habworks/Hab_hc15C/SOFTWARE/HC15C/HC15C/HC15C/ReadMe.txt

========================================================================
    APPLICATION : HC15C Project Overview
========================================================================

AppWizard has created this HC15C Application for you.  

This file contains a summary of what you will find in each of the files that
make up your HC15C application.

HC15C.vcxproj
    This is the main project file for VC++ projects generated using an Application Wizard. 
    It contains information about the version of Visual C++ that generated the file, and 
    information about the platforms, configurations, and project features selected with the
    Application Wizard.

HC15C.vcxproj.filters
    This is the filters file for VC++ projects generated using an Application Wizard. 
    It contains information about the association between the files in your project 
    and the filters. This association is used in the IDE to show grouping of files with
    similar extensions under a specific node (for e.g. ".cpp" files are associated with the
    "Source Files" filter).

HC15C.cpp
    This is the main application source file.
    Contains the code to display the form.

Form1.h
    Contains the implementation of your form class and InitializeComponent() function.

AssemblyInfo.cpp
    Contains custom attributes for modifying assembly metadata.

/////////////////////////////////////////////////////////////////////////////
Other standard files:

StdAfx.h, StdAfx.cpp
    These files are used to build a precompiled header (PCH) file
    named HC15C.pch and a precompiled types file named StdAfx.obj.

/////////////////////////////////////////////////////////////////////////////
