habworks/Hab_hc15C/FIRMWARE/When the STMPE24M31.docx

When the STMPE24M31_init runs it immediately generates an IRQ. The values of the IRQ in that sequence are typically:

0x24

0x08

0x24

0x00

0x24

0x00

By sequence I mean all of these IRQs are set one after the other, even though with each read of the INT STA, I clear the INT STA.

Note I get the INT STA readings with a reading of 0x00 on the INT STA register. Not sure what that is about

Once all of the above IRQs have been cleared the touch controller should now be looking at the keys, When I touch a key I very frequently get bit 4 (abnormal bit) set. Also interesting to note, that even though the abnormal bit is set it still sees the touch event. Any time I see an abnormal event I issue what I think is an auto tune command – though I am not sure this is what an auto tune command is.

The code that actually captures the IRQ event is ISR_STMPE24M31_AandB function. It should be pretty easy to read. Note, I am confident my I2C routines are working as they should – they never return an error. Additionally I use almost identical routines on a memory device without issue. Also I have ran the I2C interface to your part at 100kHz and 200kHz – it behaves the same.

I did toy with increasing the EVR values, but to be honest I was guessing at what I was doing. Also note my desing has 2 STMPE24M31 – the second is not working – I believe this to be a hardware issue (probably a loose connection) – either way it is not responding to I2C messages. I will try and get the second device on line tomorrow – this way I can compare the operation of both units to provide you with feedback.

I have attached my C and h file as it may help you, help me.
