habworks/Hab_hc15C/DOCUMENTS/DL/IMG_8110.JPG

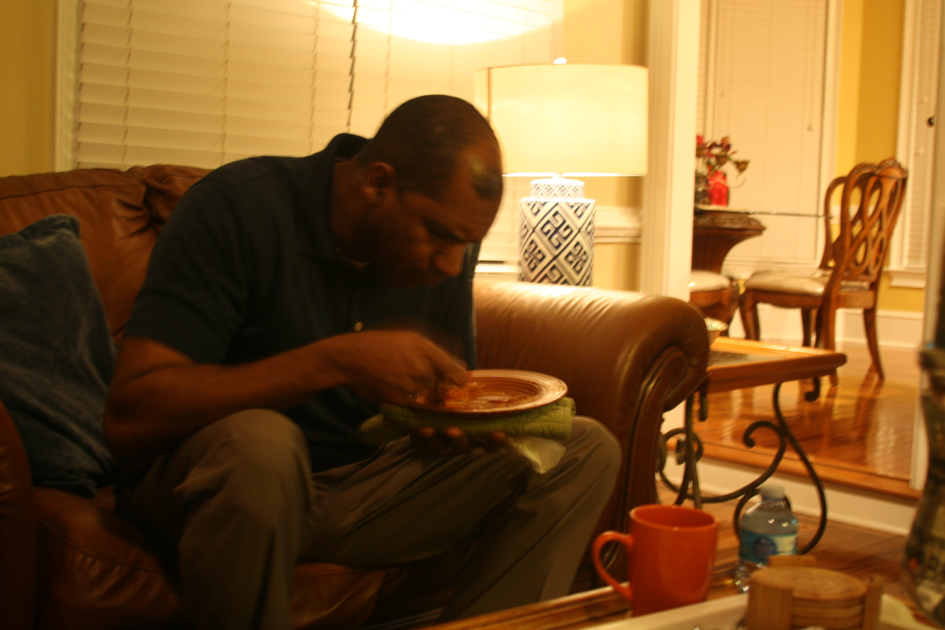
DOCUMENTS/DL/IMG_8110.JPG
