habworks/Hab_hc15C/DOCUMENTS/DL/IMG_8128.JPG

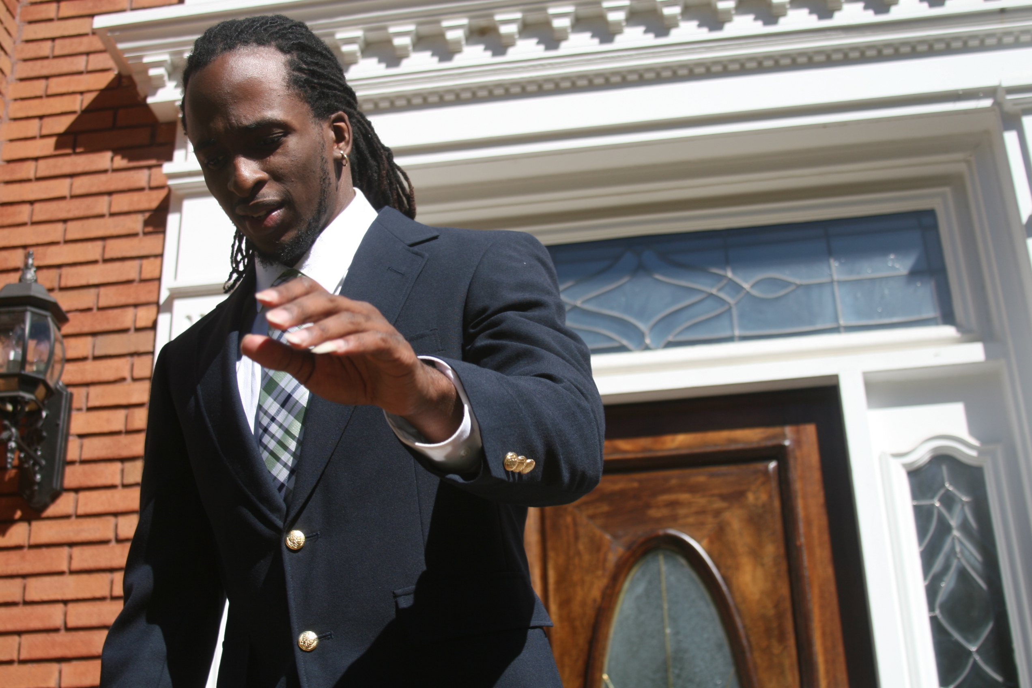
DOCUMENTS/DL/IMG_8128.JPG
