habworks/Hab_hc15C/DOCUMENTS/DL/IMG_8130.JPG

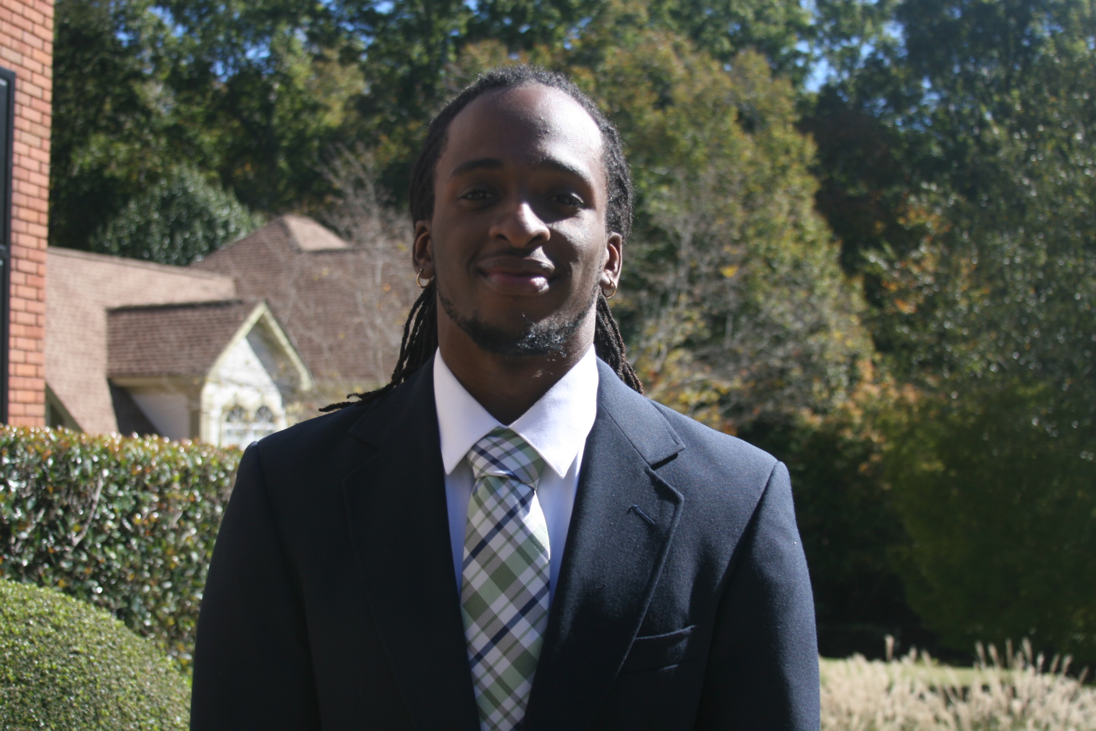
DOCUMENTS/DL/IMG_8130.JPG
