habworks/Hab_hc15C/DOCUMENTS/DL/IMG_8131.JPG

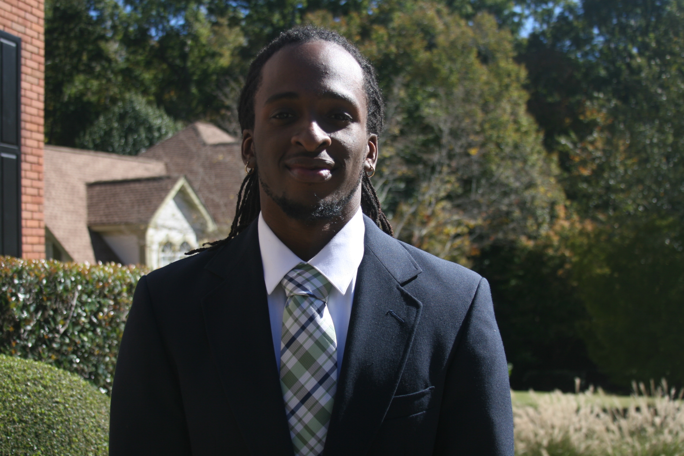
DOCUMENTS/DL/IMG_8131.JPG
