habworks/Hab_hc15C/DOCUMENTS/DL/IMG_8132.JPG

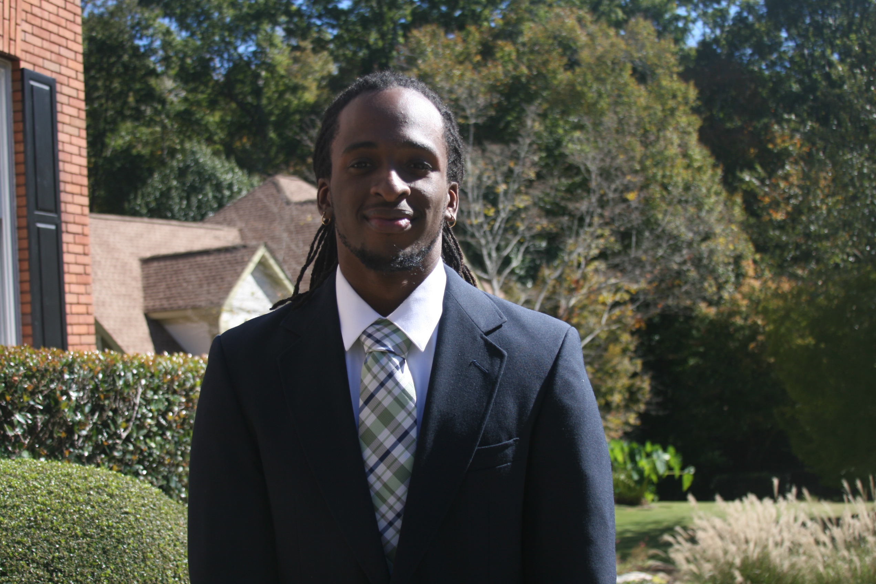
DOCUMENTS/DL/IMG_8132.JPG
