habworks/Hab_hc15C/DOCUMENTS/DL/IMG_8133.JPG

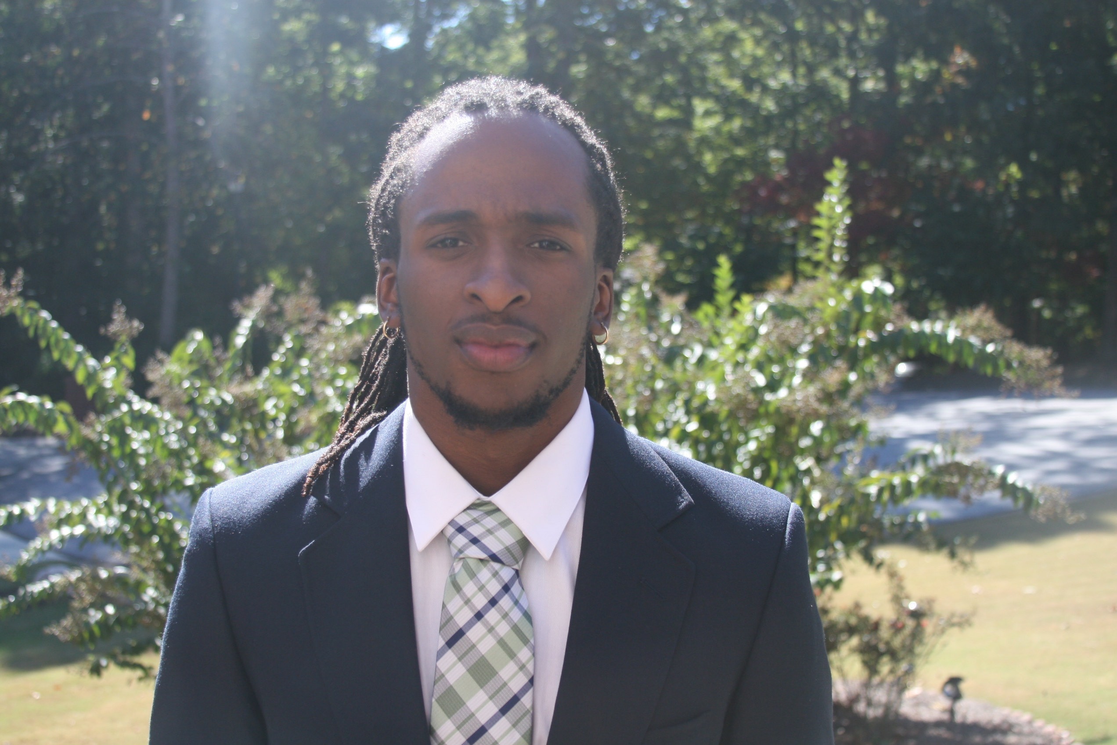
DOCUMENTS/DL/IMG_8133.JPG
