habworks/Hab_hc15C/DOCUMENTS/DL/IMG_8135.JPG

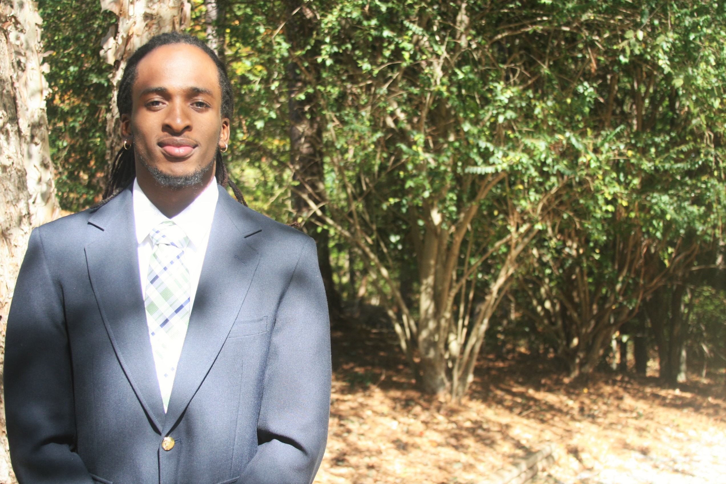
DOCUMENTS/DL/IMG_8135.JPG
