habworks/Hab_hc15C/DOCUMENTS/DL/IMG_8137.JPG

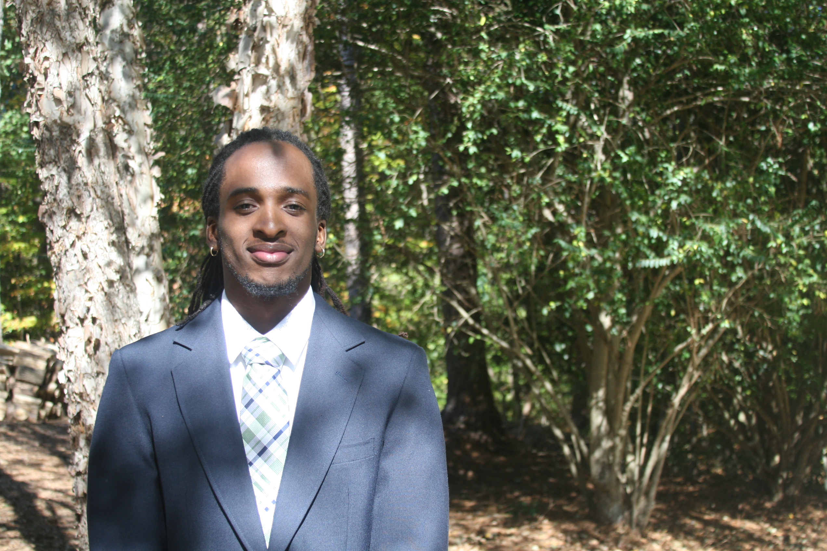
DOCUMENTS/DL/IMG_8137.JPG
