habworks/Hab_hc15C/DOCUMENTS/DL/IMG_8139.JPG

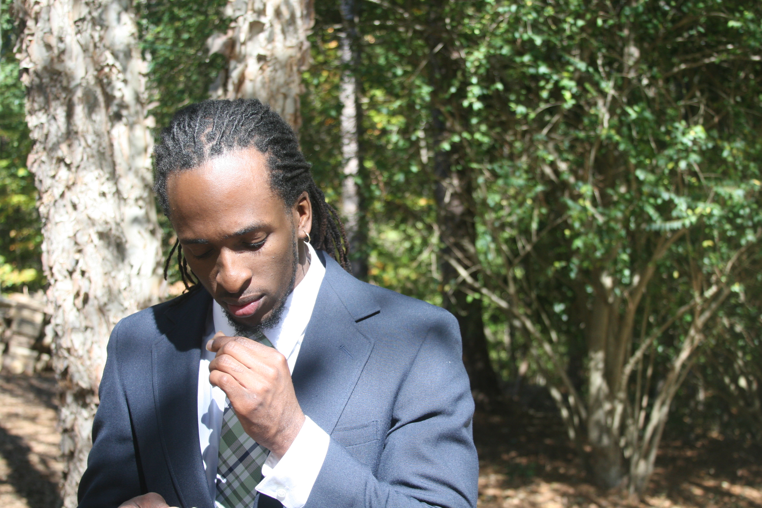
DOCUMENTS/DL/IMG_8139.JPG
