habworks/Hab_hc15C/DOCUMENTS/DL/IMG_8140.JPG

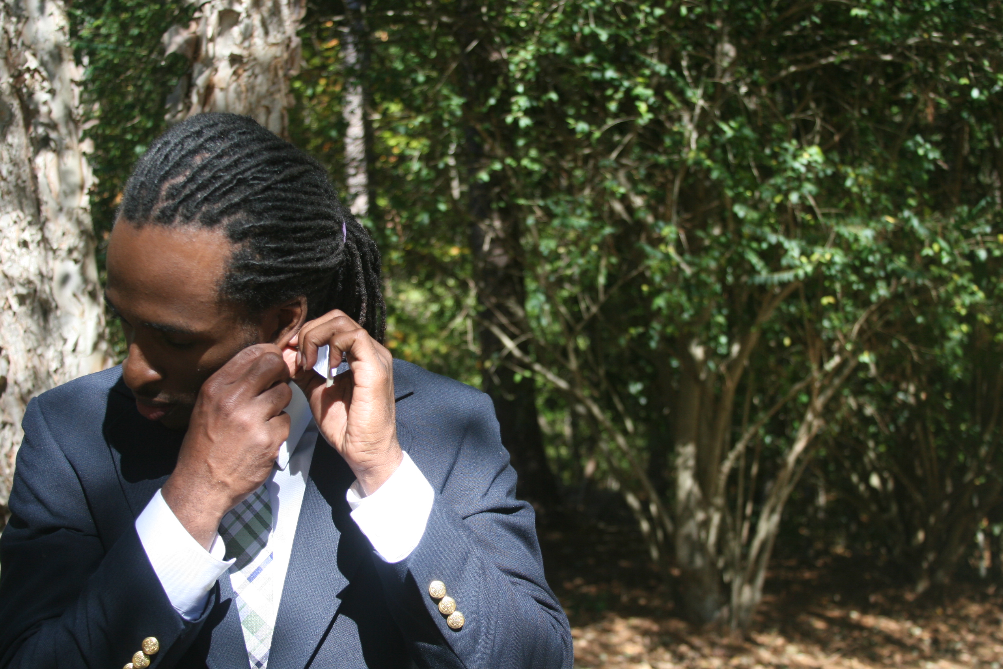
DOCUMENTS/DL/IMG_8140.JPG
