habworks/Hab_hc15C/DOCUMENTS/DL/IMG_8141.JPG

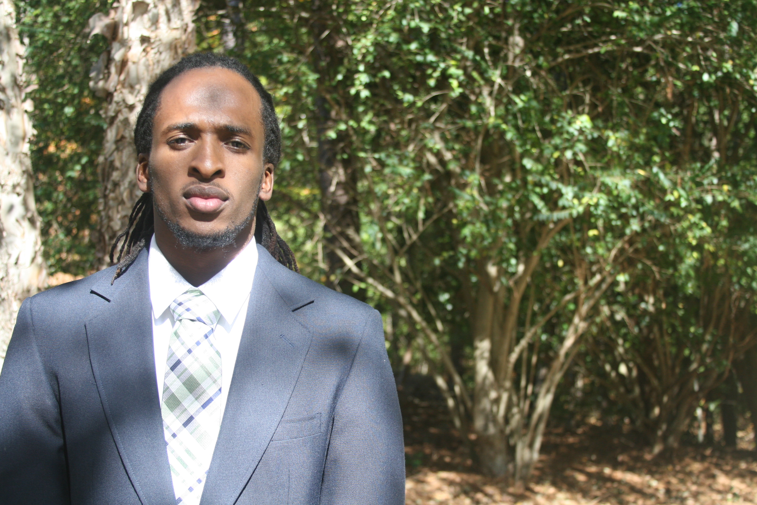
DOCUMENTS/DL/IMG_8141.JPG
