habworks/Hab_hc15C/DOCUMENTS/DL/IMG_8142.JPG

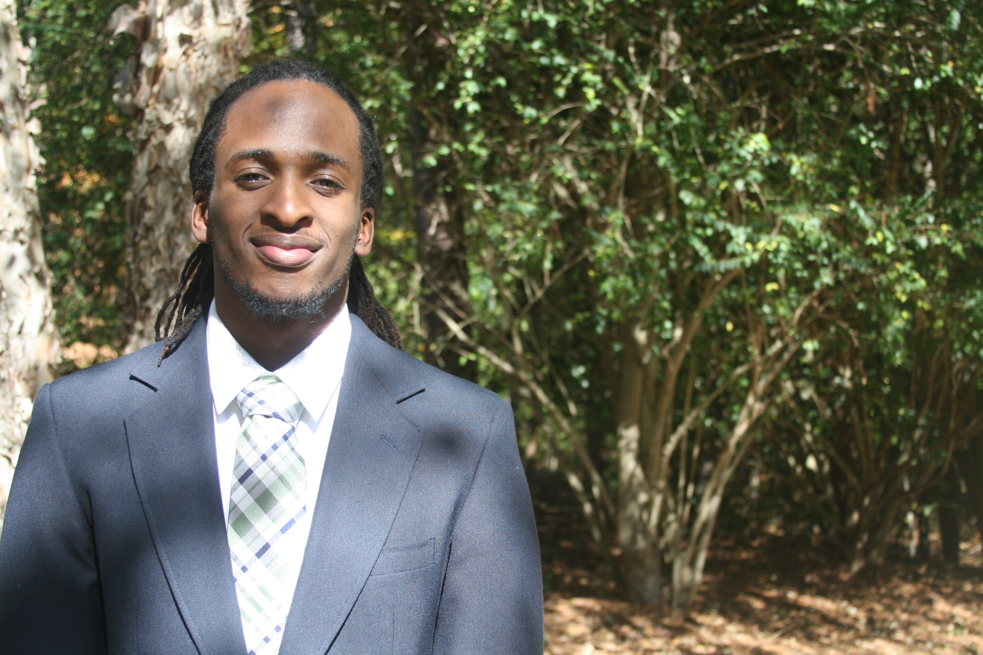
DOCUMENTS/DL/IMG_8142.JPG
