habworks/Hab_hc15C/DOCUMENTS/DL/IMG_8145.JPG

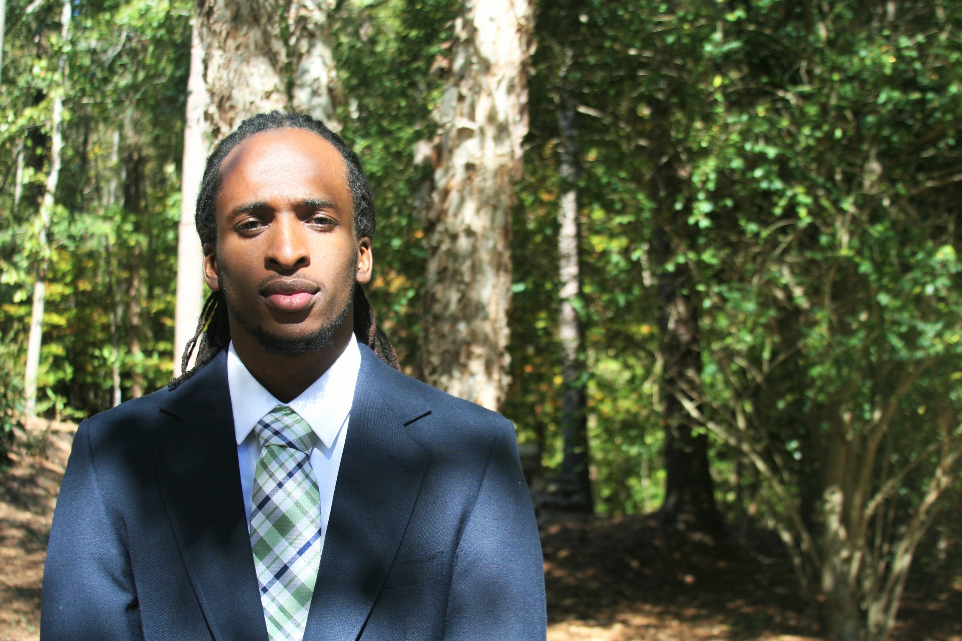
DOCUMENTS/DL/IMG_8145.JPG
