habworks/Hab_hc15C/DOCUMENTS/DL/IMG_8147.JPG

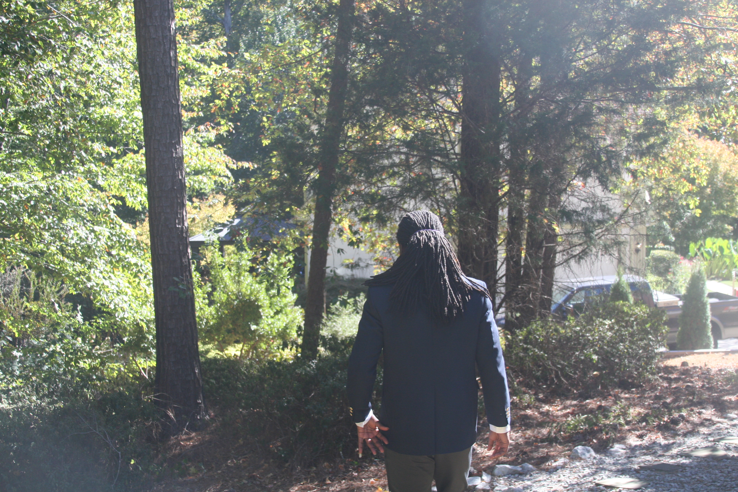
DOCUMENTS/DL/IMG_8147.JPG
