habworks/Hab_hc15C/DOCUMENTS/DL/IMG_8148.JPG

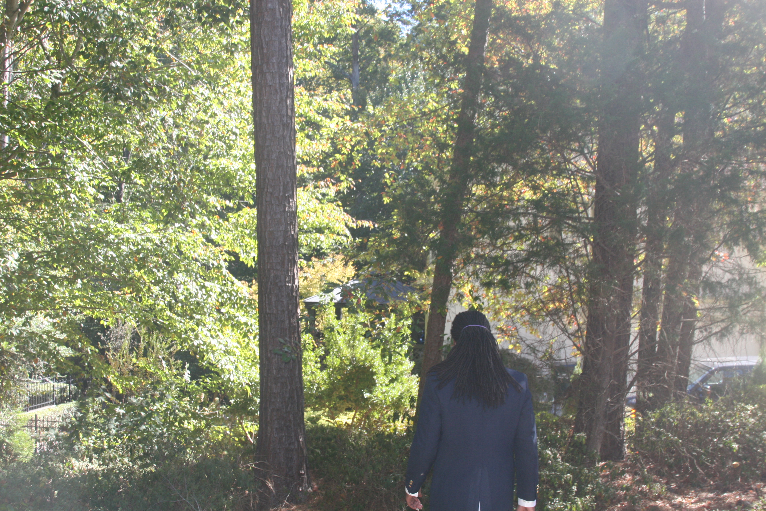
DOCUMENTS/DL/IMG_8148.JPG
