habworks/Hab_hc15C/DOCUMENTS/DL/IMG_8149.JPG

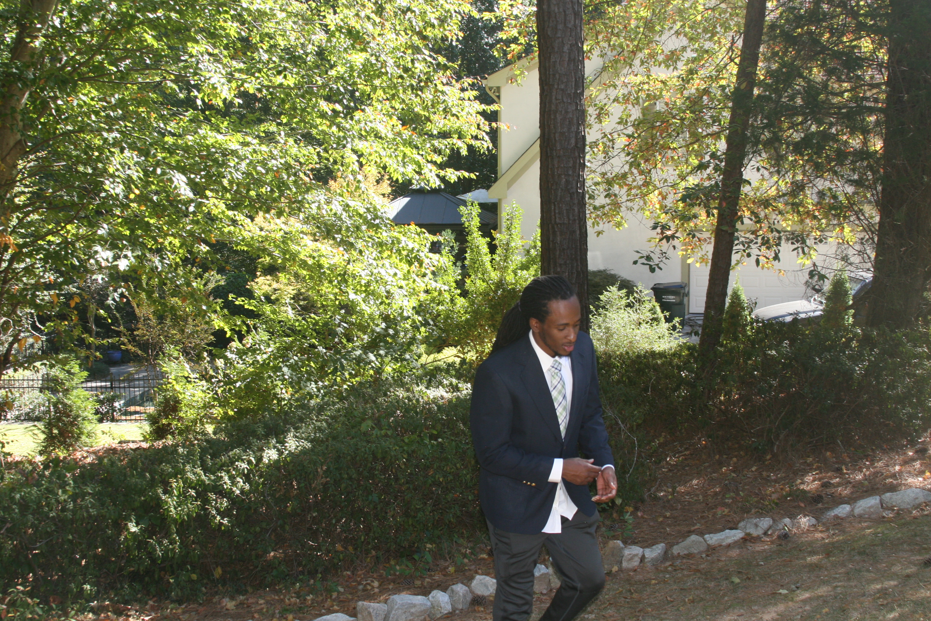
DOCUMENTS/DL/IMG_8149.JPG
