habworks/Hab_hc15C/DOCUMENTS/DL/IMG_8155.JPG

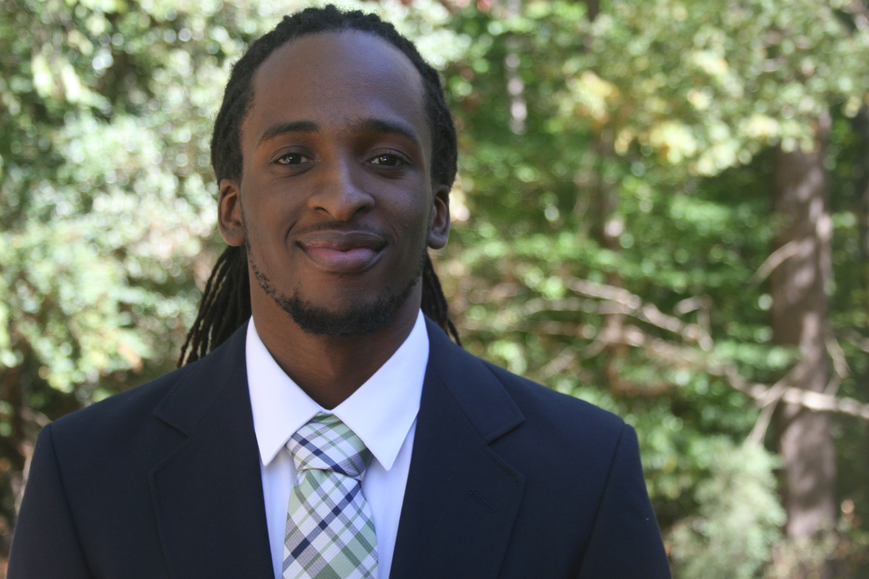
DOCUMENTS/DL/IMG_8155.JPG
