habworks/Hab_hc15C/DOCUMENTS/DL/IMG_8158.JPG

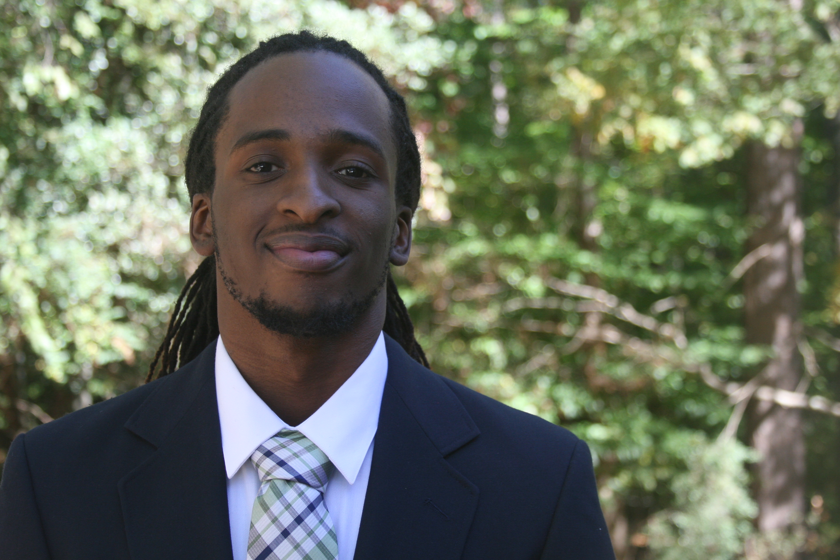
DOCUMENTS/DL/IMG_8158.JPG
