habworks/Hab_hc15C/DOCUMENTS/DL/IMG_8159.JPG

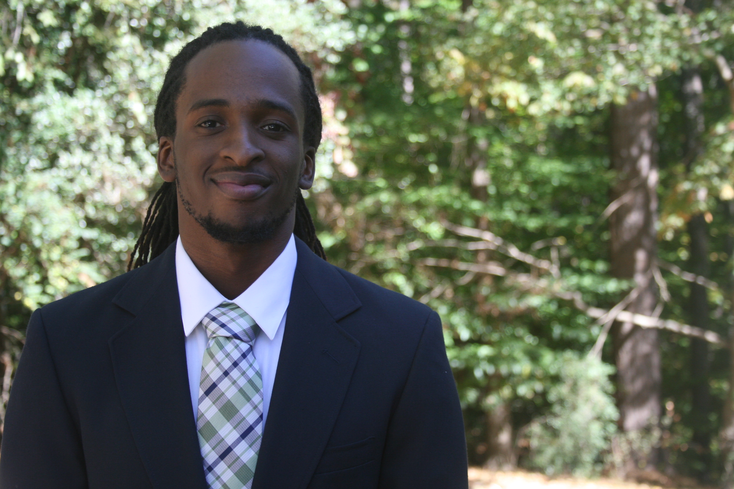
DOCUMENTS/DL/IMG_8159.JPG
