habworks/Hab_hc15C/DOCUMENTS/DL/IMG_8163.JPG

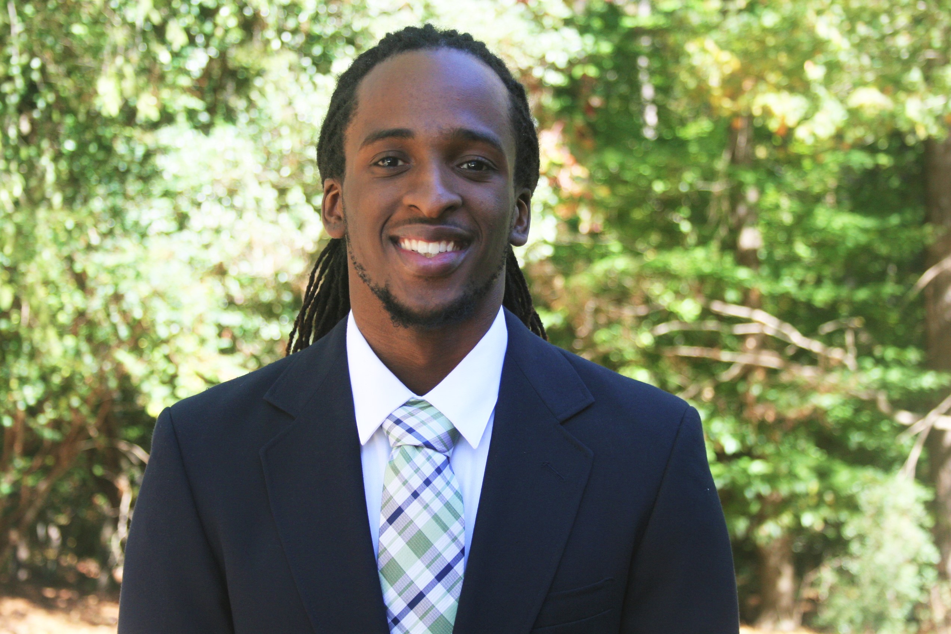
DOCUMENTS/DL/IMG_8163.JPG
