habworks/Hab_hc15C/DOCUMENTS/DL/IMG_8164.JPG

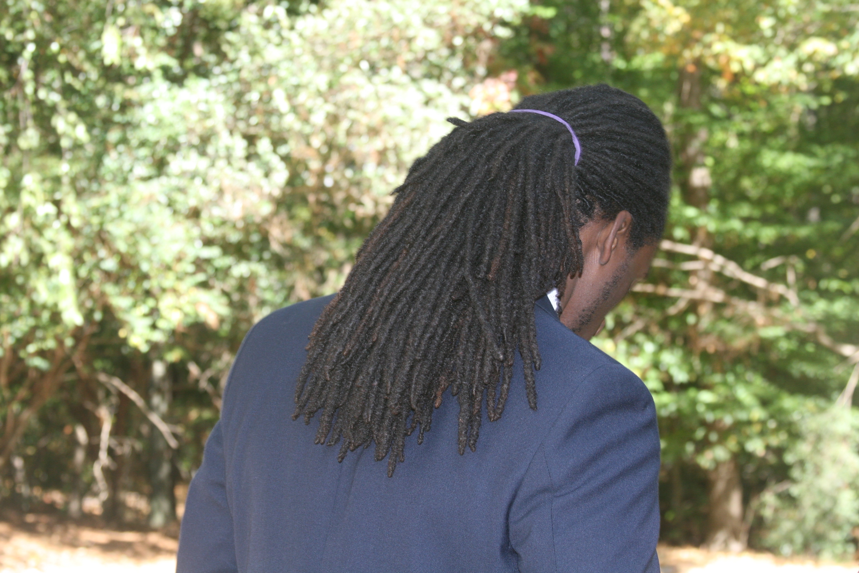
DOCUMENTS/DL/IMG_8164.JPG
