habworks/Hab_hc15C/DOCUMENTS/DL/IMG_8165.JPG

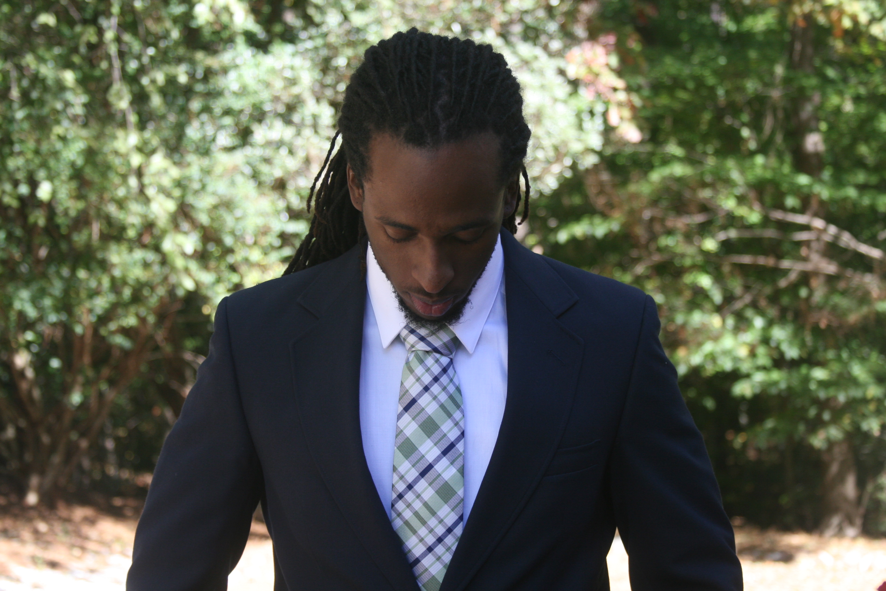
DOCUMENTS/DL/IMG_8165.JPG
