habworks/Hab_hc15C/DOCUMENTS/DL/IMG_8166.JPG

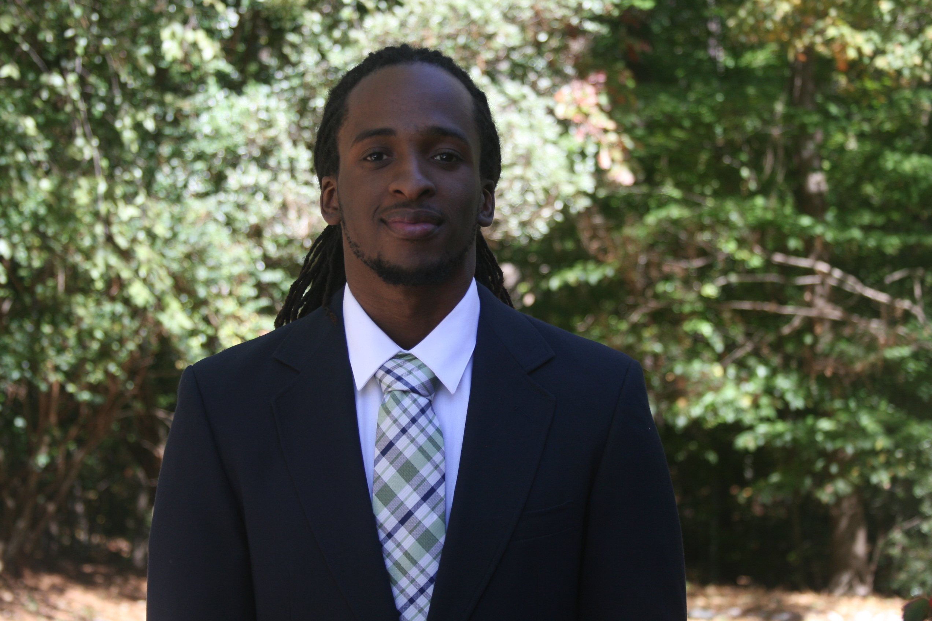
DOCUMENTS/DL/IMG_8166.JPG
