habworks/Hab_hc15C/DOCUMENTS/DL/IMG_8167.JPG

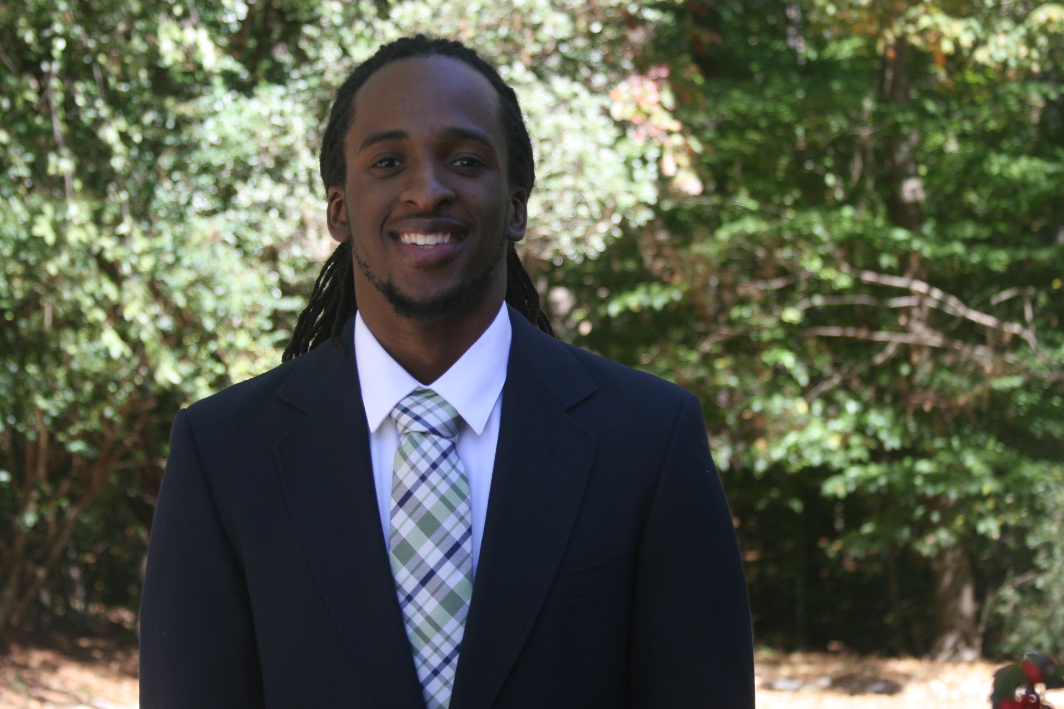
DOCUMENTS/DL/IMG_8167.JPG
