habworks/Hab_hc15C/DOCUMENTS/DL/IMG_8169.JPG

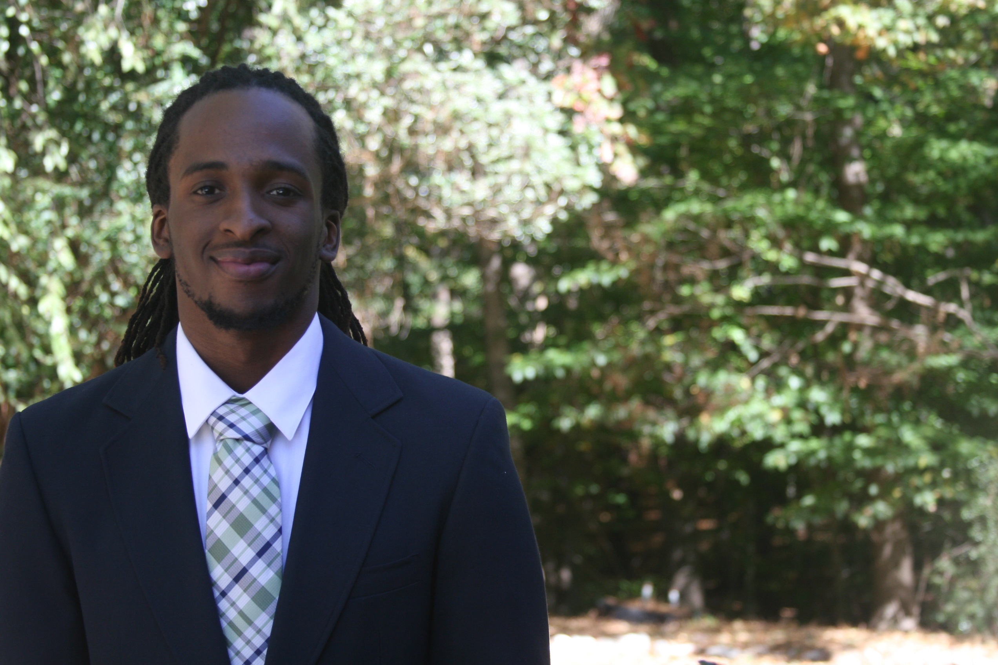
DOCUMENTS/DL/IMG_8169.JPG
