habworks/Hab_hc15C/DOCUMENTS/DL/IMG_8170.JPG

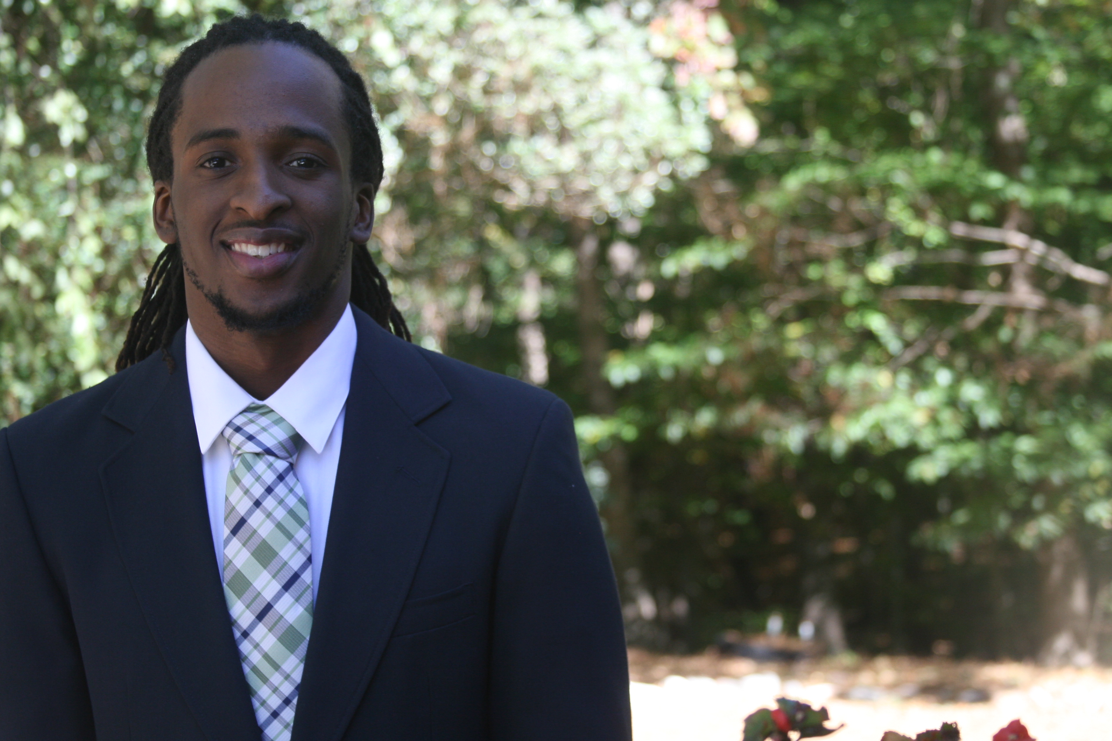
DOCUMENTS/DL/IMG_8170.JPG
