habworks/Hab_hc15C/DOCUMENTS/DL/IMG_8171.JPG

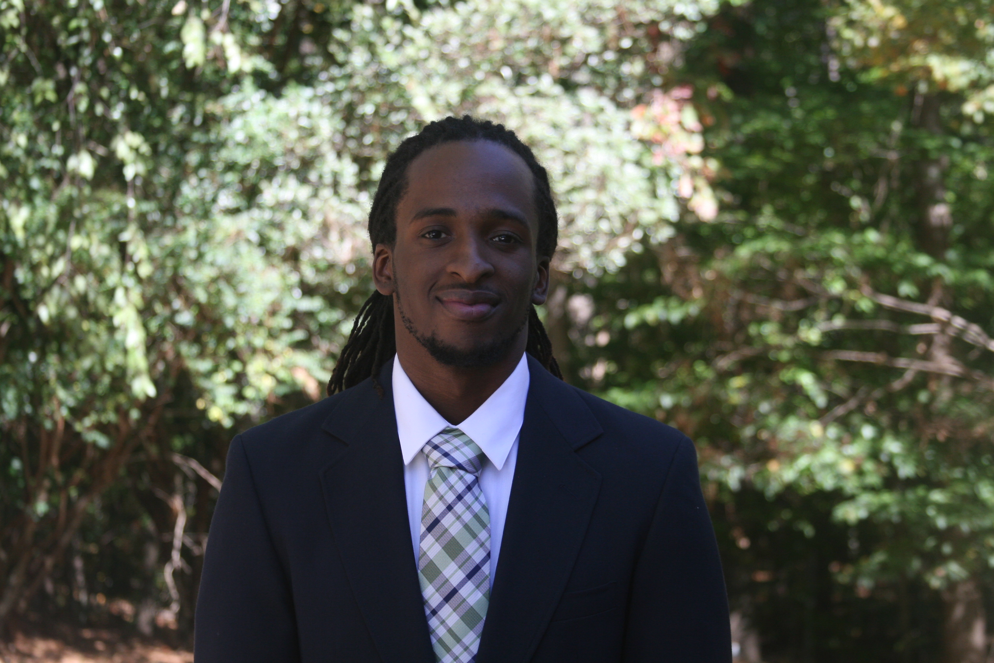
DOCUMENTS/DL/IMG_8171.JPG
