habworks/Hab_hc15C/DOCUMENTS/DL/IMG_8174.JPG

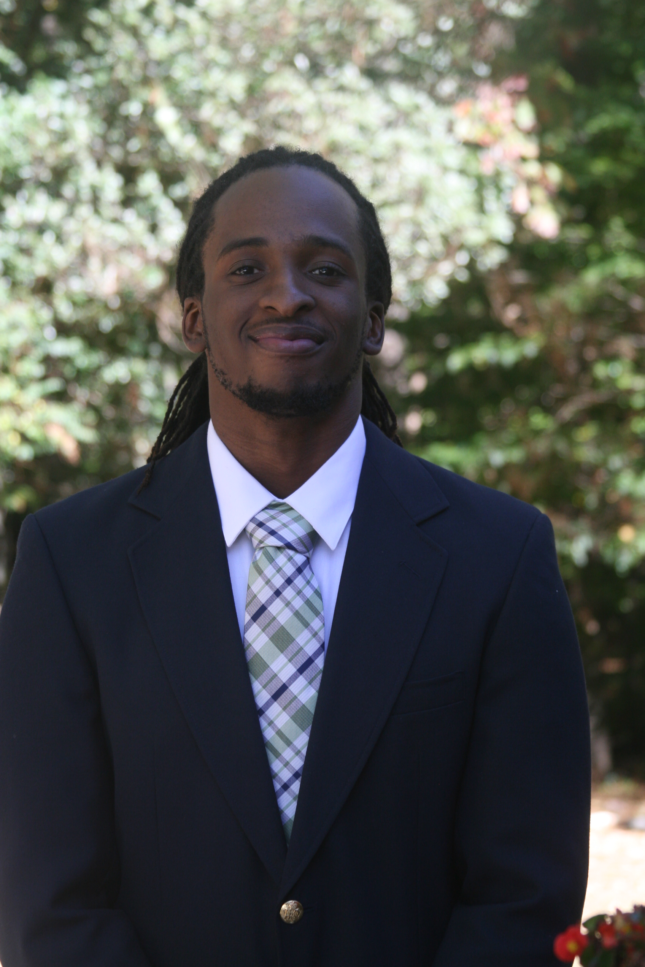
DOCUMENTS/DL/IMG_8174.JPG
