habworks/Hab_hc15C/DOCUMENTS/DL/IMG_8175.JPG

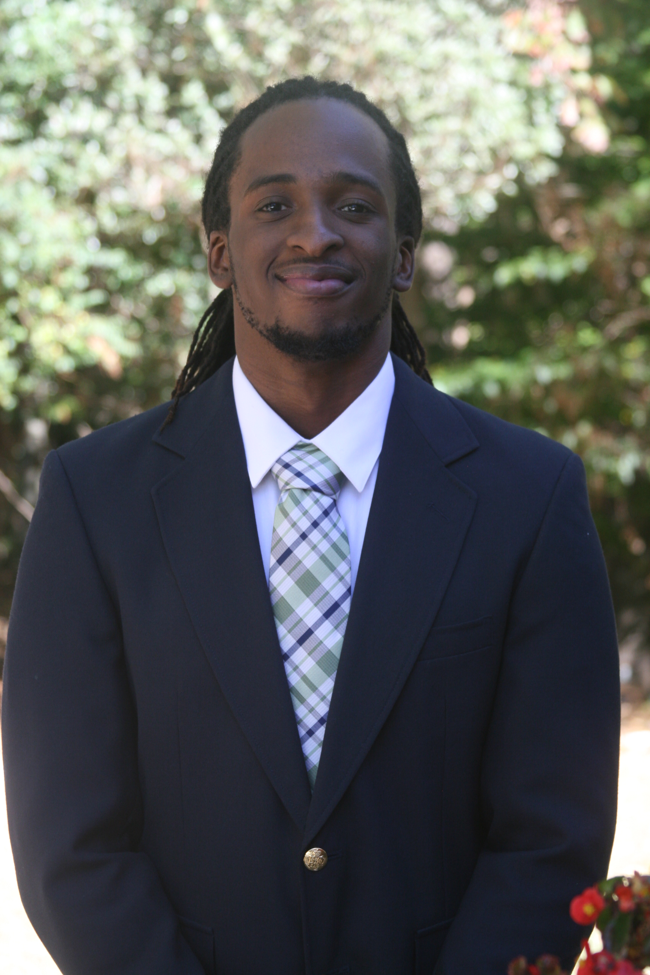
DOCUMENTS/DL/IMG_8175.JPG
