habworks/Hab_hc15C/DOCUMENTS/DL/IMG_8176.JPG

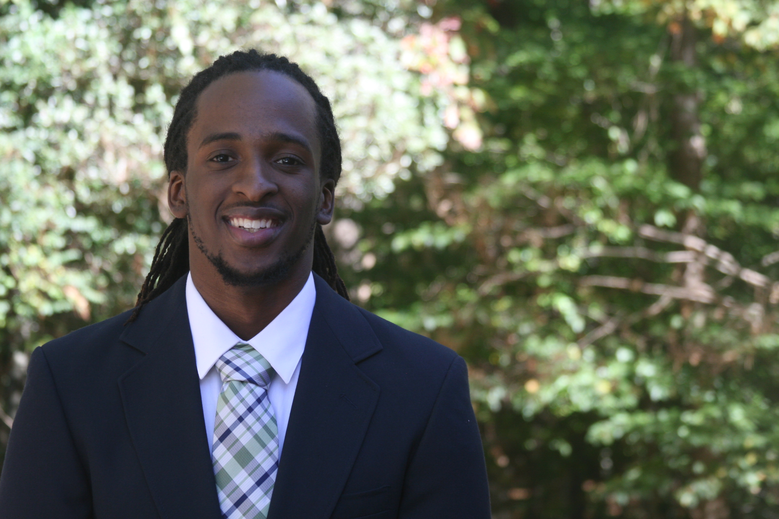
DOCUMENTS/DL/IMG_8176.JPG
