habworks/Hab_hc15C/DOCUMENTS/DL/IMG_8179.JPG

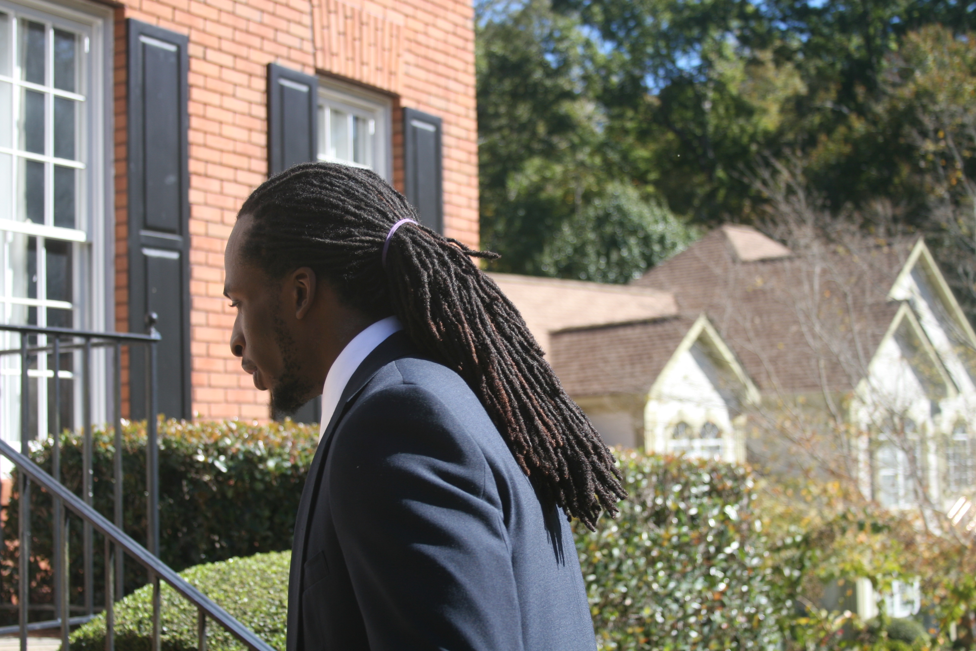
DOCUMENTS/DL/IMG_8179.JPG
