habworks/Hab_hc15C/Project Outputs for HAB CAL/REV1/HC 15C REV1.xls

Comment | Quantity | Designator | Description | MFG | MFG_PN | Supplier 1 | Supplier Part Number 1
CDEVA00082_1 | 1 | BAT1 | CONN, BAT HOLDER 2-COIN CELL 20MM, SMD, ROHS | KEYSTONE ELECTRONICS | 1062 | Digi-Key | 1062K-ND
CDECA00095 | 4 | C1, C2, C6, C7 | CAP, CERAMIC, NPO, 18PF, 50V, 1206, 5%, RoHS | YAGEO | CC1206JRNPO9BN180 | Digi-Key | 311-1152-1-ND
CDECA00070 | 28 | C3, C8, C9, C11, C12, C13, C14, C15, C16, C17, C18, C19, C20, C21, C22, C23, C24, C29, C30, C31, C32, C33, C34, C35, C36, C38, C42, C44 | CAP, CERAMIC CHIP 0.1UF 10% 50V X7R ROHS | AVX | 12065C104KAT2A | Digi-Key | 478-1556-1-ND
CDECA00143 | 4 | C4, C5, C25, C26 | CAP, CERAMIC, NPO, 10PF, 50V, 1206, 5%, RoHS | AVX | 12065A100DAT2A | Digi-Key | 478-5053-1-ND
CDECA00139_2 | 1 | C10 | CAP, TANT, 220UF, 6.3V, 20%, LOW ESR, 3528, ROHS | KEMET | T520B227M006ATE070 | Digi-Key | 399-5756-1-ND
CDECA00122 | 2 | C27, C28 | CAP, CERAMIC CHIP 1UF 10% 50V X7R ROHS | AVX | GRM32RR71H105K | Digi-Key | 490-1863-1-ND
CDECA00143_1 | 1 | C37 | CAP, CERAMIC, X7R, 150NF, 50V, 1206, 10%, RoHS | KEMET | C0805C154K5RACTU | Digi-Key | 399-3489-1-ND
CDECA00139_1 | 1 | C39 | CAP, TANT, 22UF, 6.3V, 20%, LOW ESR, 1206ROHS | AVX | TAJA226K006RNJ | Digi-Key | 478-3865-1-ND
CDECA00085 | 4 | C40, C41, C45, C46 | CAP, CERAMIC CHIP 0.01UF 10% 50V X7R ROHS | PANASONIC | ECJ-1VB1H103K | Digi-Key | PCC1784CT-ND
CDECA00110_1 | 1 | C43 | CAP, TANT, 47UF, 25V, 20%, 3528 ROHS | AVX | TAJB476M010RNJ | Digi-Key | 478-3891-1-ND
CDEDA00019 | 5 | D1, D16, D17, D18, D23 | Diode, Schottky rectifier, 40V, 1A, SMB package, Pb free | ON SEMICONDUCTOR | MBRS140T3G | Digi-Key | MBRS140T3GOSCT-ND
CDELA00019_1 | 5 | D2, D3, D4, D5, D6 | DIODE,LED RED UNDER MOUNT SM VF=1.8 I=2MA ROHS | OSRAM | LS M47K-J2L1-1-Z | Digi-Key | 475-2762-1-ND
CDEDA00043 | 1 | D7 | DIODE, ZENER, 5.1V, 225MW, SOT-23, ROHS | ON SEMICONDUCTOR | BZX84C5V1LT1G | Digi-Key | BZX84C5V1LT1GOSCT-ND
CDEDA00037_1 | 4 | D8, D9, D11, D12 | VARISTOR, TVS, 5.5VDC, 1206, 150A, .60J, RoHS | LITTLEFUSE | V5.5MLA1206NH | Digi-Key | F2219TR-ND
CDEDA00020 | 3 | D10, D13, D14 | DIODE, 150MA, 100V, SOD123 | DIODES INC | 1N4148W-7-F | Digi-Key | 1N4148W-FDICT-ND
CDEDA00055_1 | 1 | D15 | DIODE, ZENER, 18V, 225MW, SOT-23, ROHS | ON SEMICONDUCTOR | BZX84C18LT1G | Digi-Key | BZX84C18LT1GOSCT-ND
CDEDA00055_3 | 2 | D19, D21 | DIODE, 1A, 100V, SMA, ROHS | FAIRCHILD SEMICONDUCTOR | S1B | Digi-Key | S1BFSCT-ND
CDEDA00055_2 | 2 | D20, D22 | DIODE, ZENER, 33V, 225MW, SOT-23, ROHS | ON SEMICONDUCTOR | BZX84C33LT1G | Digi-Key | BZX84C33LT1GOSCT-ND
CDEVA00115 | 5 | FB1, FB2, FB3, FB4, FB5 | FERRITE, 1KOHM AT 100MHZ, 220MA, .450DCR | MURATA | BLM21AG102SN1D | Digi-Key | 490-1041-1-ND
CDTDA00013 | 1 | J1 | CONN, HDR, 2X10, 100MIL, TH, ROHS | TYCO ELECTRONICS | 5103309-5 | Digi-Key | A33166-ND
CDTDA_1 | 2 | J2, J3 | CONN, RCPTL MICRO USB TYPE AB, SM RA | TYCO | 1981584-1 | Digi-Key | A97799CT-ND
CDTDA_2 | 1 | J4 | CONN, MICRO SD, SM, ROHS | 3M | 2908-05WB-MG | Digi-Key | 3M5607CT-ND
CDTTB001 | 1 | J5 | CONN, HDR, 2PIN, 5MM PHONIX CONTACT, ROHS | PHOENIX CONTACT | 1933189 | Digi-Key | 277-1645-ND
CDEHA00005_1 | 1 | L1 | INDUCTOR, 33UH, 10%, SMT, NON-SHIELDED, FERRITE CORE, ROHS | BOURNS | SDR0805-330KL | Digi-Key | SDR0805-330KLCT-ND
CDENA00031 | 3 | Q1, Q3, Q10 | MOSFET P CHN, VDS=30V, RDSON = .6OHM, SOT 23 | INTERNATIONAL RECTIFIER | IRLML5103 | Digi-Key | IRLML5103PBFCT-ND
CDENA00031_1 | 1 | Q2 | MOSFET P CHN, VDS=50V, RDSON = 10OHM, SOT 23 | DIODES INC | BSS84-7-F | Digi-Key | P59.0KFCT-ND
CDENA00031_3 | 3 | Q4, Q5, Q14 | MOSFET P CHN, VDS=12V, RDSON = .05OHM, SOT 23 | INTERNATIONAL RECTIFIER | IIRLML6401TRPBF | Digi-Key | IRLML6401PBFCT-ND
CDENA00030 | 5 | Q6, Q7, Q8, Q9, Q15 | MOSFET N CHN, VDS=60V, 115 mA, SOT 23 | DIODES INC | 2N7002-7-F | Digi-Key | 2N7002-FDICT-ND
CDENA00031_2 | 4 | Q11, Q12, Q13, Q16 | MOSFET N CHN, VDS=60V, 115 mA, SOT 23 | INTERNATIONAL RECTIFIER | IRLML2803TRPBF | Digi-Key | IRLML2803PBFCT-ND
CDERA00170 | 15 | R1, R2, R3, R4, R5, R6, R12, R13, R24, R25, R26, R27, R29, R30, R35 | RESISTOR, CHIP 1206 10K OHM 1% 1/4W THICK FILM ROHS | PANASONIC | ERJ-8GEYJ103V | Digi-Key | P10KECT-ND
CDERA00192 | 6 | R7, R8, R9, R10, R11, R45 | RESISTOR, CHIP 1206 180 OHM 1% 1/4W THICK FILM ROHS | PANASONIC | ERJ-8ENF1800V | Digi-Key | P180FCT-ND
CDERA00275_9 | 1 | R14 | RESISTOR, CHIP 1206 3K OHM 1% 1/4W THICK FILM ROHS | PANASONIC | ERJ-8ENF3001V | Digi-Key | P3.00KFCT-ND
CDERA00198 | 8 | R15, R20, R33, R37, R39, R43, R54, R56 | RESISTOR, CHIP 1206 100K OHM 1% 1/4W THICK FILM ROHS | PANASONIC | ERJ-8ENF1003V | Digi-Key | P100KFCT-ND
CDERA00179 | 1 | R16 | RESISTOR, CHIP 1206 1.5K OHM 1% 1/4W THICK FILM ROHS | PANASONIC | ERJ-8GEYJ152V | Digi-Key | P1.5KECT-ND
CDERA00169 | 1 | R17 | RESISTOR, CHIP 1206 4.7K OHM 1% 1/4W THICK FILM ROHS | PANASONIC | ERJ-8GEYJ472V | Digi-Key | P4.7KECT-ND
CDERA00207 | 2 | R18, R19 | RESISTOR, CHIP 1206 33 OHM 1% 1/4W THICK FILM ROHS | PANASONIC | ERJ-8ENF33R0V | Digi-Key | P33.0FCT-ND
CDERA00191 | 2 | R21, R22 | RESISTOR, CHIP 1206 1MOHM 1% 1/4W THICK FILM ROHS | PANASONIC | ERJ-8GEYJ105V | Digi-Key | P1.0MECT-ND
CDERA00207_2 | 1 | R23 | RESISTOR, POT 10K OHM 20% THUMBWHELL, CERM, TH, ROHS | BOURNS | 3352T-1-103LF | Digi-Key | 3352T-103LF-ND
CDERA00142 | 1 | R28 | RESISTOR, CHIP 1206 10 OHM 1% 1/4W THICK FILM ROHS | PANASONIC | ERJ-8ENF10R0V | Digi-Key | P10.0FCT-ND
CDERA00176 | 1 | R31 | RESISTOR, CHIP 1206 100 OHM 1% 1/4W THICK FILM ROHS | PANASONIC | ERJ-8GEYJ101V | Digi-Key | P100ECT-ND
CDERA00154 | 2 | R32, R57 | RESISTOR, CHIP 1206 330 OHM 1% 1/4W THICK FILM ROHS | PANASONIC | ERJ-8ENF3300V | Digi-Key | P330FTR-ND
CDERA00275_8 | 3 | R34, R36, R44 | RESISTOR, CHIP 1206 300K OHM 1% 1/4W THICK FILM ROHS | PANASONIC | ERJ-8ENF3003V | Digi-Key | P300KFCT-ND
CDERA00273_2 | 1 | R38 | RESISTOR, CHIP 1206 220 OHM 1% 1/4W THICK FILM ROHS | PANASONIC | ERJ-8ENF2200V | Digi-Key | P220FCT-ND
CDERA00273_1 | 1 | R40 | RESISTOR, CHIP 1206 3.32K OHM 1% 1/4W THICK FILM ROHS | PANASONIC | ERJ-8ENF3321V | Digi-Key | P3.32KFCT-ND
CDERA00275_2 | 1 | R41 | RESISTOR, CHIP 1206 11K OHM 1% 1/4W THICK FILM ROHS | PANASONIC | ERJ-8ENF1102V | Digi-Key | P11.0KFCT-ND
CDERA00275_7 | 1 | R42 | RESISTOR, CHIP 1206 59K OHM 1% 1/4W THICK FILM ROHS | PANASONIC | ERJ-8ENF5902V | Digi-Key | P59.0KFCT-ND
CDERA00195 | 2 | R46, R55 | RESISTOR, CHIP 1206 1K OHM 1% 1/4W THICK FILM ROHS | PANASONIC | ERJ-8ENF1001V | Digi-Key | P1.00KFCT-ND
CDERA00275_4 | 1 | R47 | RESISTOR, CHIP 1206 30K OHM 1% 1/4W THICK FILM ROHS | PANASONIC | ERJ-8ENF3002V | Digi-Key | P30.0KFCT-ND
CDERA00275_5 | 1 | R48 | RESISTOR, CHIP 1206 12K OHM 1% 1/4W THICK FILM ROHS | PANASONIC | ERJ-8ENF1202V | Digi-Key | P12.0KFCT-ND
CDERA00275_3 | 1 | R49 | RESISTOR, CHIP 1206 7.5K OHM 1% 1/4W THICK FILM ROHS | PANASONIC | ERJ-8ENF7501V | Digi-Key | P7.50KFCT-ND
CDERA00181 | 2 | R50, R51 | RESISTOR, CHIP 1206 0.0 OHM 1% 1/4W THICK FILM ROHS | PANASONIC | ERJ-8GEYJ122V | Digi-Key | P0.0ECT-ND
CDERA00275_6 | 1 | R52 | RESISTOR, CHIP 1206 357 OHM 1% 1/4W THICK FILM ROHS | PANASONIC | ERJ-8ENF3570V | Digi-Key | P357FCT-ND
CDERA00209 | 1 | R53 | RESISTOR, CHIP 1206 270 OHM 1% 1/4W THICK FILM ROHS | PANASONIC | ERJ-8ENF2700V | Digi-Key | P270FCT-ND
CDEVA_2 | 1 | SPK1 | SPEAKER 8OHM .7W 88DB 13MM SMD | PUI AUDIO | SMS-1308MS-R | Digi-Key | 668-1206-1-ND
CDESA00095 | 2 | SW1, SW2 | SWITCH, MOM, NO, SM | PANASONIC | EVQ-QXS02W | Digi-Key | P13612SCT-ND
CDELA00023_1 | 1 | U1 | LCD, 4X20 WITH ICONS, SERIAL INTERFACE, 5X8DOT, WHITE BACKLIGHT | ELECTRONIC ASSEMBLY | EA DIP204J-6NLW
CDEUA00070_1 | 1 | U2 | IC, TXRX USB TO UART BRIDGE, ROHS, 28QFN | SILICON LABS | CP2101-GM | Digi-Key | 336-1162-ND
CDEUA00049 | 1 | U3 | IC, SHUNT VOLTAGE REFERENCE | TEXAS INSTRUMENTS | LM4040C30IDBZR | Digi-Key | 296-20887-1-ND
CDEUA00069_2 | 1 | U4 | IC, MICRO CONTROLLER, 512KB FLASH, 64K, ARM CORTEX M3, 100LQFP | NXP | LPC1769FBD100 | Digi-Key | 568-4966-ND
CDEUA00071_1 | 1 | U5 | IC AUDIO AMP, CLASS AB, 325mW, 8SOIC, ROHS | NATIONAL SEMICONDUCTOR | LM386M-1/NOPB | Digi-Key | LM386M-1-ND
CDEUA00020 | 1 | U6 | IC, EEPROM, I2C, 256x8, 8PIN SO8, ROHOS | ATMEL | AT24C02N-10SU-2.7 | Digi-Key | AT24C02N-10SU-2.7-ND
CDEUA00052_1 | 2 | U7, U8 | IC, TOUCHKEY CONTROLLER, 24CH, I2C, 40QFN | ST | STMPE24M31 | Digi-Key | 497-10380-1-ND
CDEUA00014_1 | 1 | U9 | IC, BUCK REGULATOR, 0.6A, TSOT23-6 | NATIONAL SEMICONDUCTOR | LM2842XMK-ADJL/NOPB | Digi-Key | LM2842XMK-ADJLCT-ND
CDEUA00013_1 | 1 | U10 | IC, PHOTOCOUPLER, NPN OUTPUT - NO BASE, SM, ROHS | SHARP MICROELECTRONICS | PC817X2NIP0F | Digi-Key | 425-2192-1-ND
CDEKA00015 | 1 | X1 | CRYSTAL, 32.768KHZ, 12.5PF, SMT SM CYLINDRICAL CAN | CITIZEN | CMR200T32.768KDZF-UT | Digi-Key | 300-8340-1-ND
CDEKA00019 | 1 | X2 | CRYSTAL, 12.000MHZ, 18PF, SMT HC49/US | CITIZEN | HCM49-12.000MABJ-UT | Digi-Key | 300-8548-1-ND
