habworks/Hab_hc15C/FIRMWARE/extracted/_htmlsrc/lib_building_page_files/image002.jpg

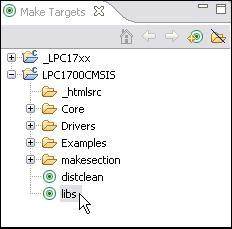
FIRMWARE/extracted/_htmlsrc/lib_building_page_files/image002.jpg
