habworks/Hab_hc15C/FIRMWARE/extracted/_htmlsrc/evaluation_board_page_files/image002.jpg

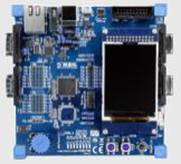
FIRMWARE/extracted/_htmlsrc/evaluation_board_page_files/image002.jpg
