habworks/Hab_hc15C/FIRMWARE/extracted/_htmlsrc/debugger_page_files/image001.jpg

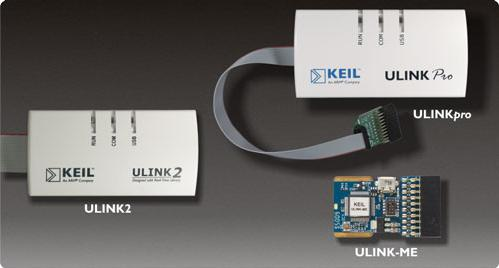
FIRMWARE/extracted/_htmlsrc/debugger_page_files/image001.jpg
