habworks/Hab_hc15C/FIRMWARE/extracted/_htmlsrc/mcb1700-schematics.pdf

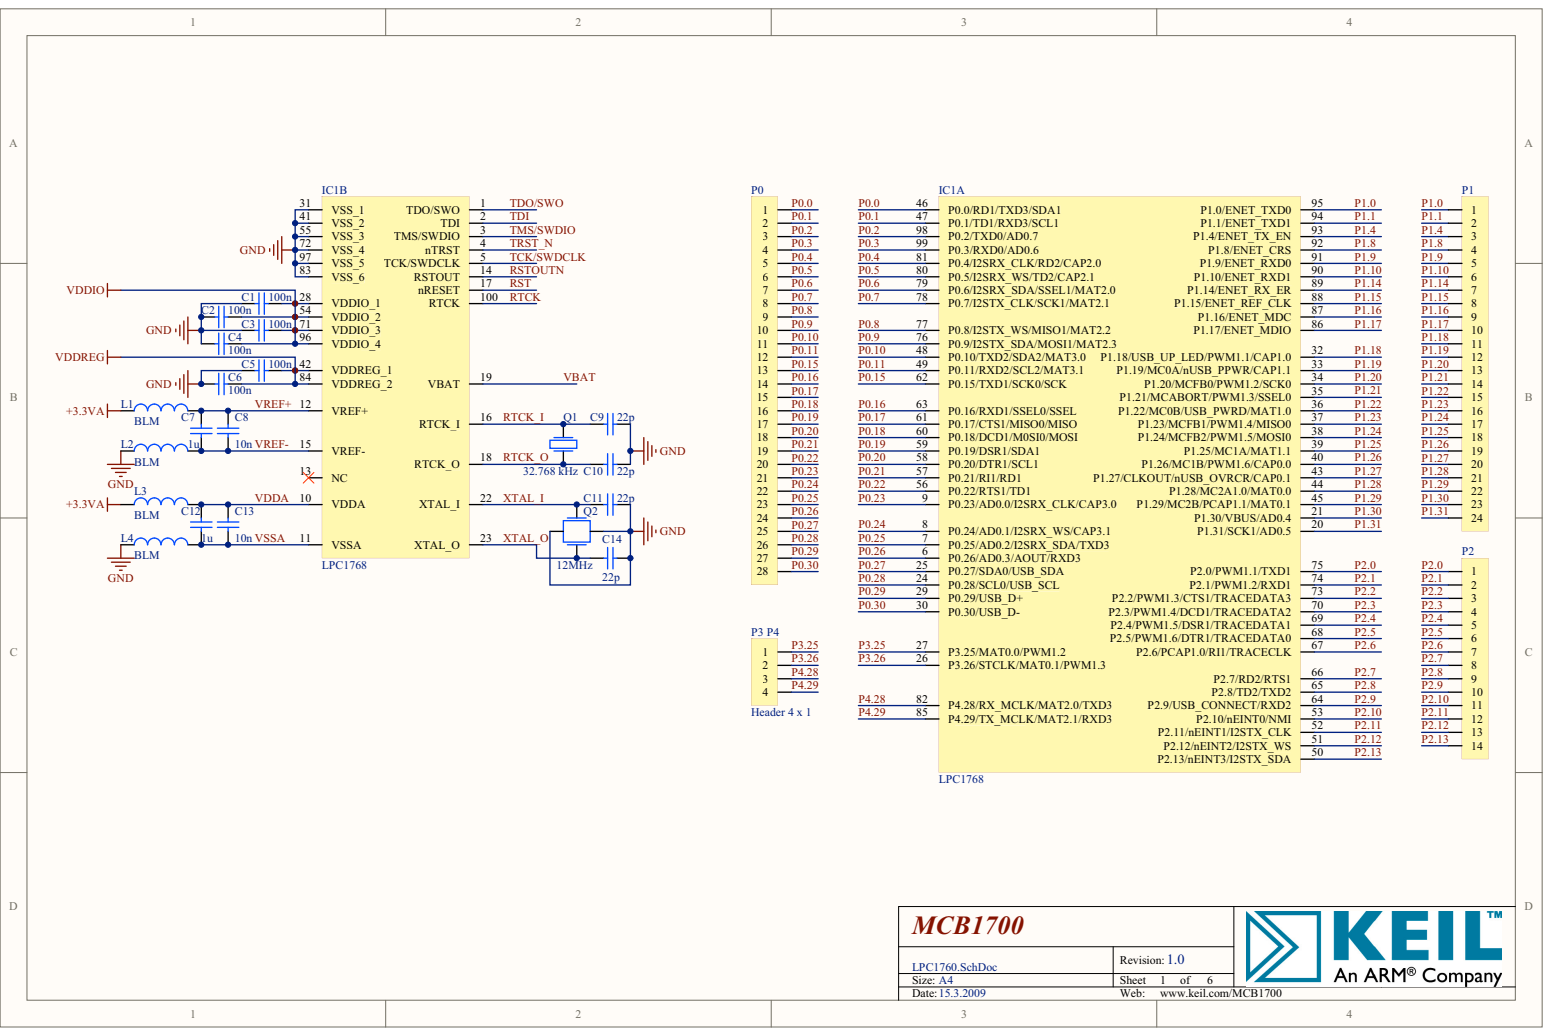
[picture p41: page 1]

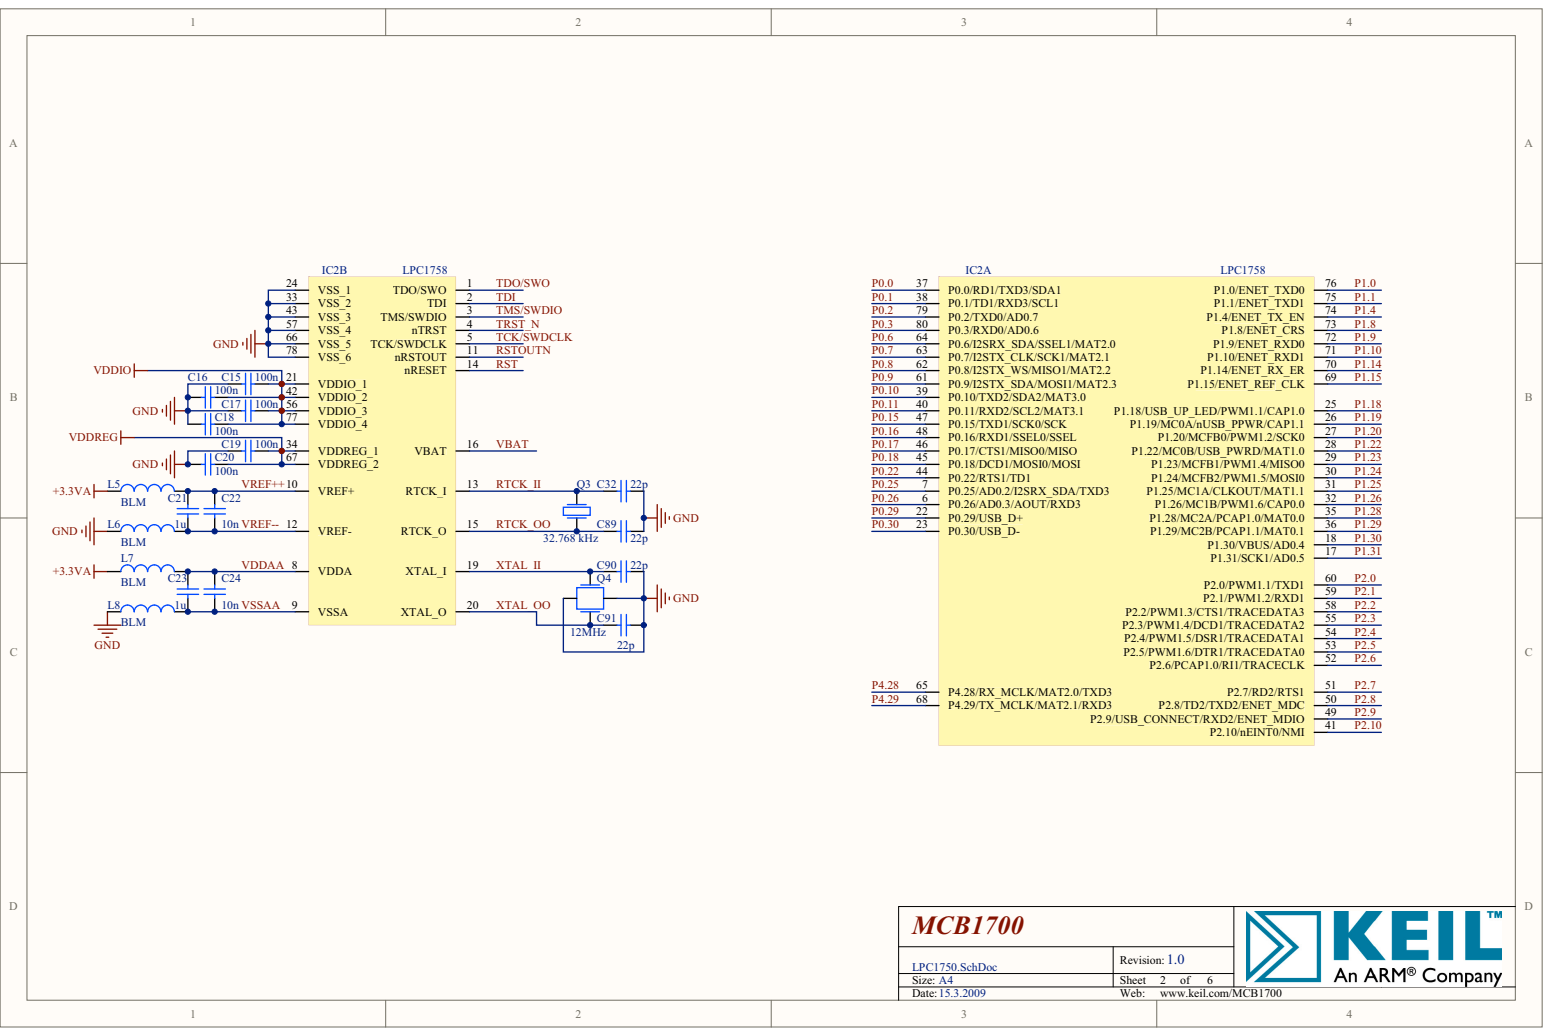
[picture p42: page 2]

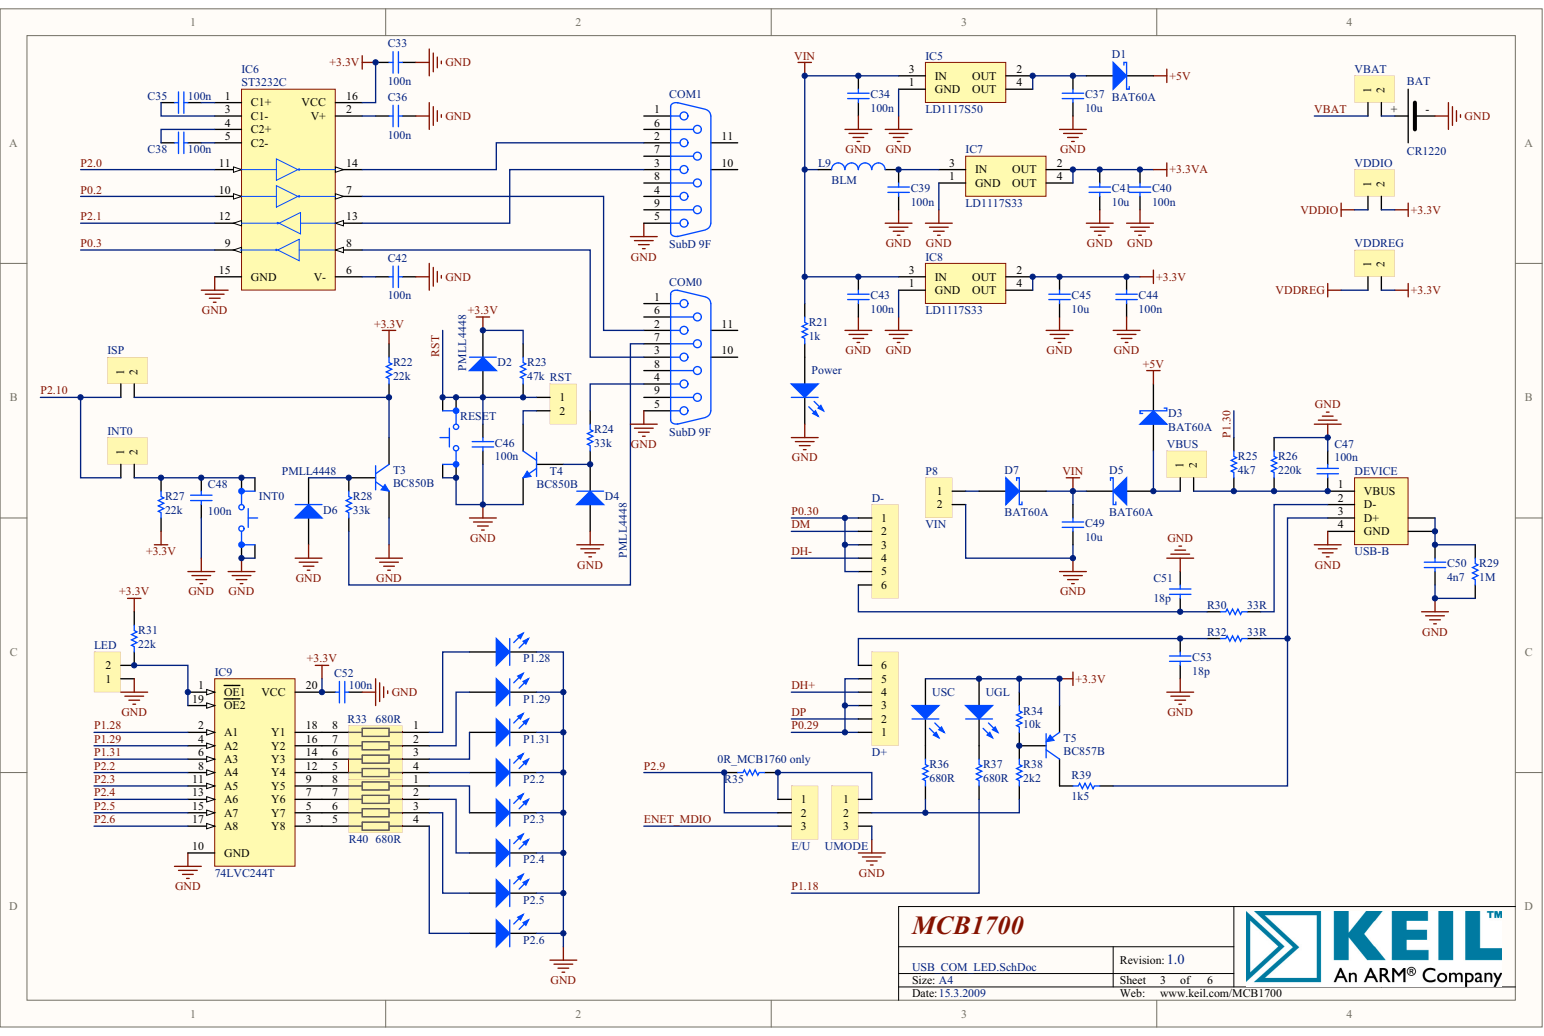
[picture p43: page 3]

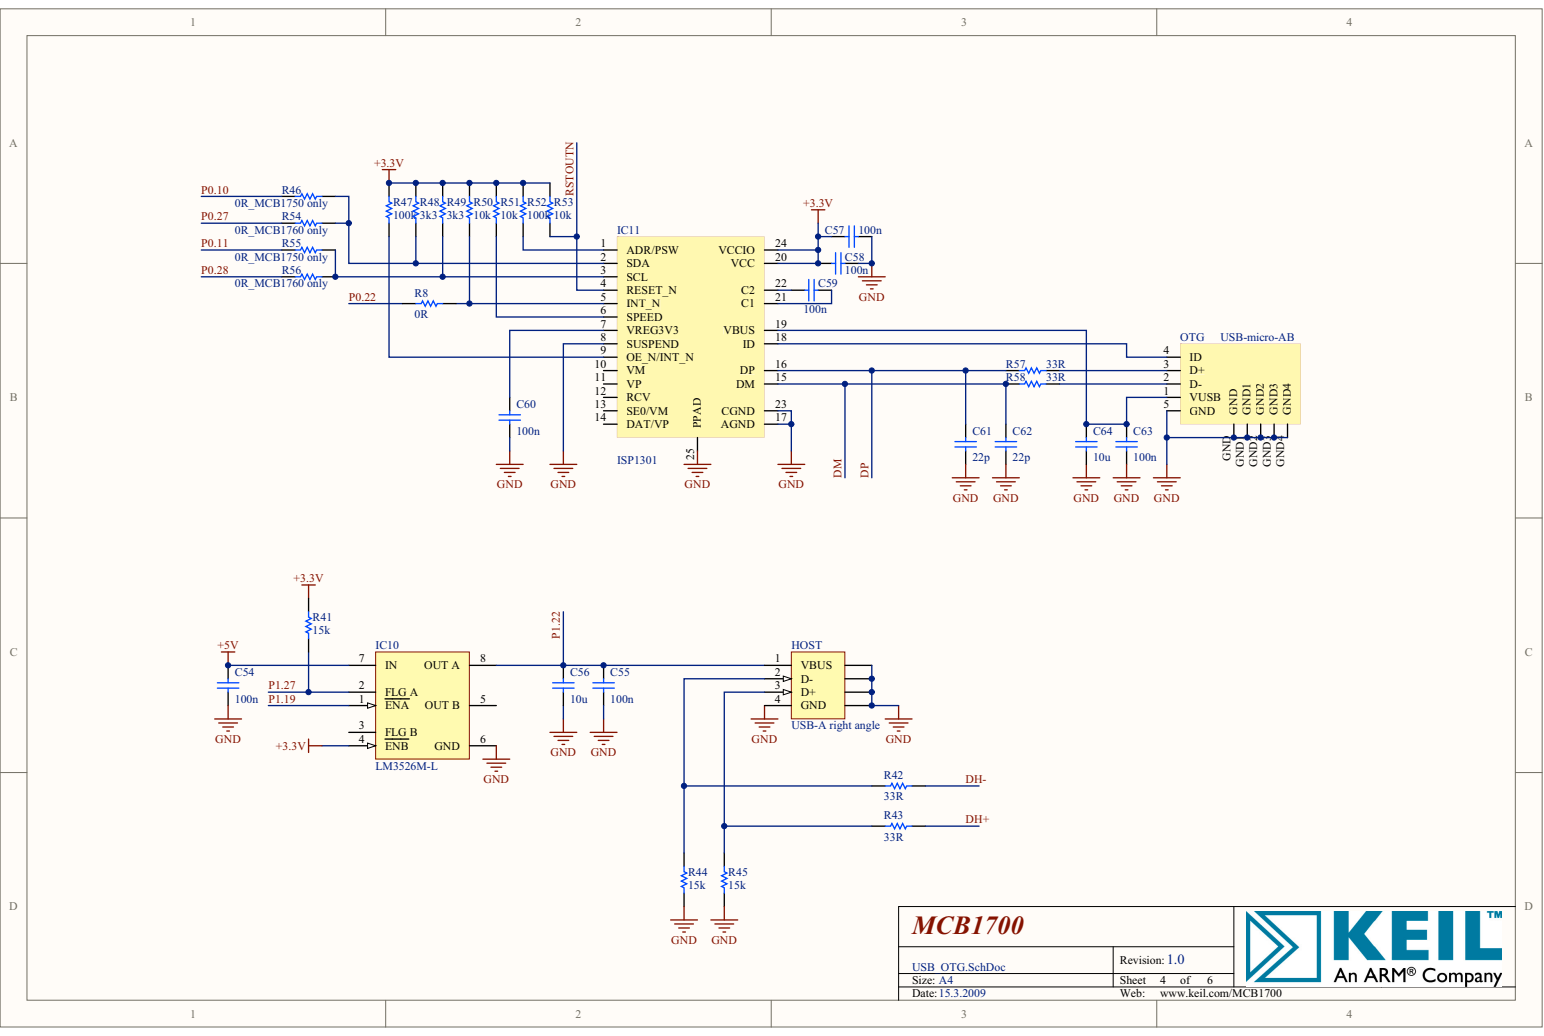
[picture p44: page 4]

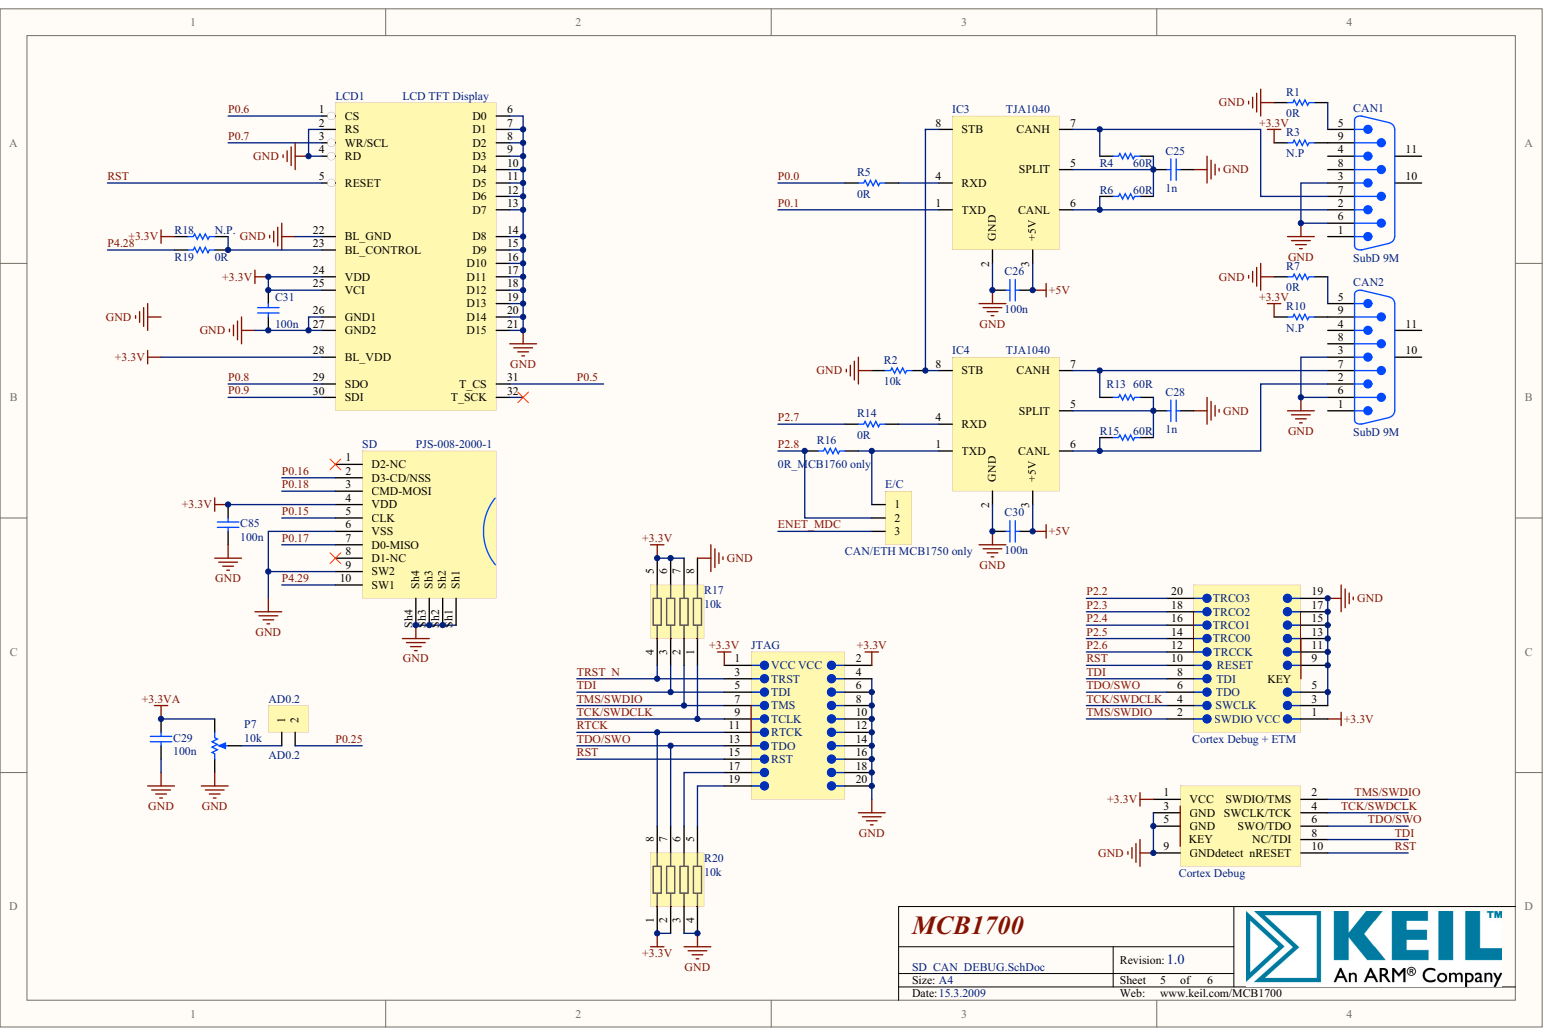
[picture p45: page 5]

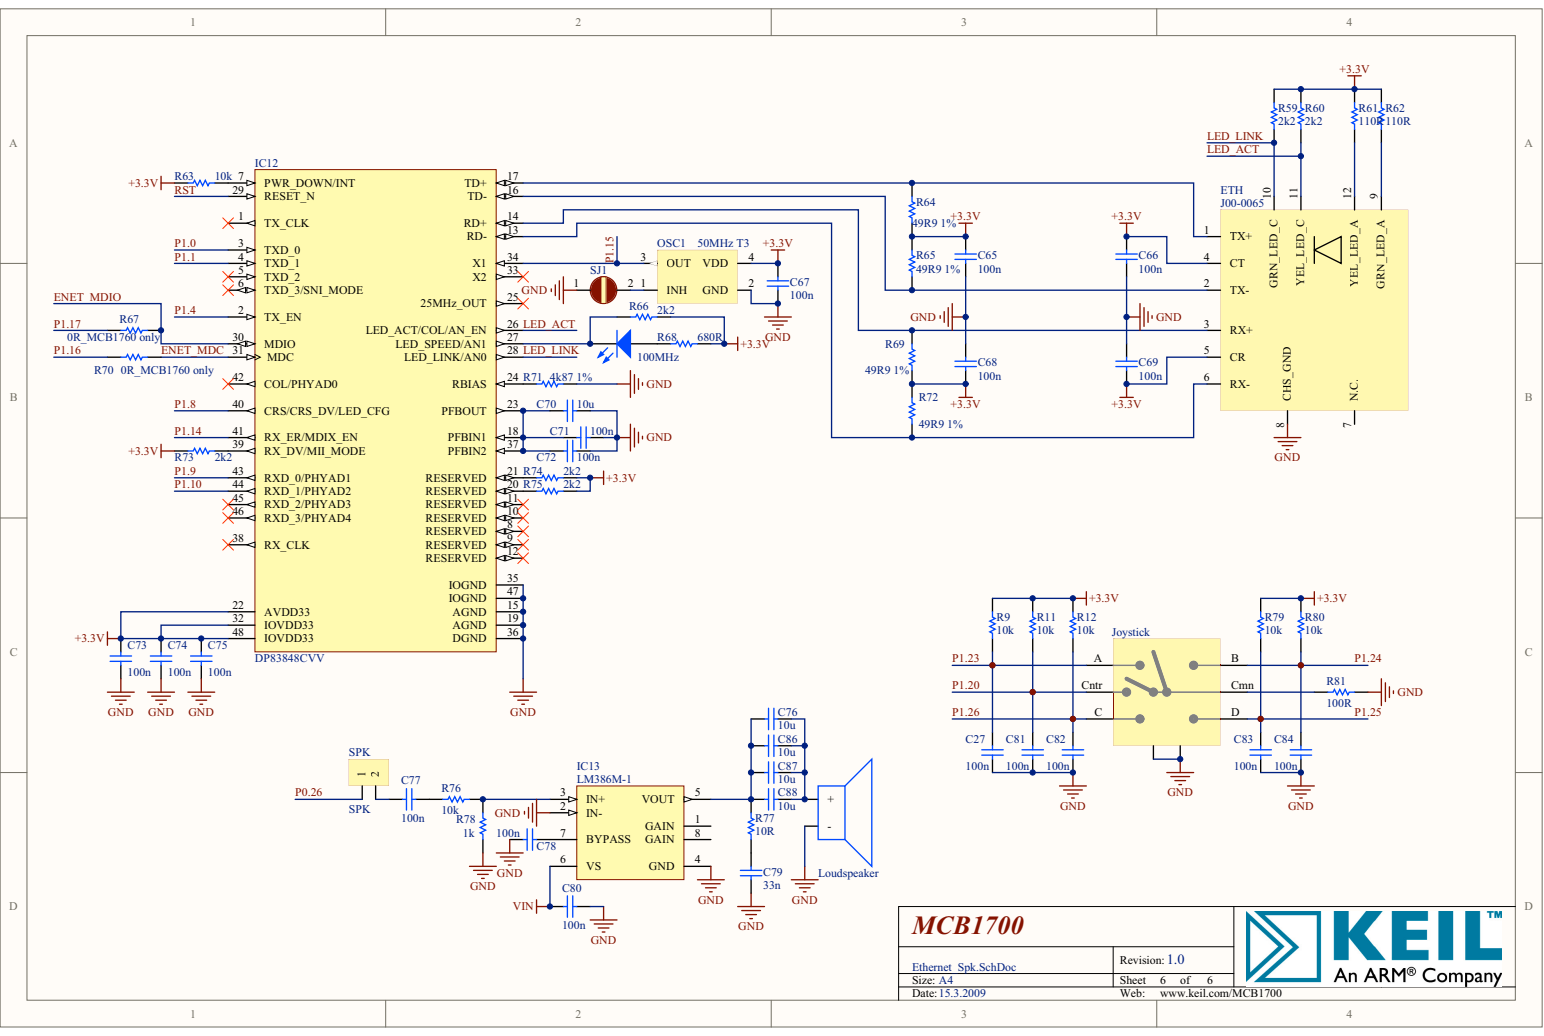
[picture p46: page 6]
