habworks/Hab_hc15C/SIM/CAL_PWR-1.asc

C1: cap; 47µF
D1: schottky; MBR0520L
D2: schottky; MBR0520L
D3: schottky; MBR0520L
D4: schottky; MBR0520L
D5: LED; LXHL-BW02
M1: nmos; 2N7002
M2: nmos; 2N7002
R1: res; 300K
R2: res; 100K
R3: res; 10K
R4: res; 330
R5: res; 220
R6: res; 10K
R7: res; 50
SW1: sw; USB_PlugInOut
U1: IRLML6401
U6: IRLML6401
U7: IRLML6401
U8: IRLML6401
V1: voltage; 6
V2: voltage; 5
V3: voltage; PULSE(0 5 .05 .0001 .0001 .1 .2)
Named nets: 0, VUSB, VOUT
.tran 1
.model USB_PlugInOut SW(Ron=.1 Roff=100Meg Vt=3 Vh=-.5)
