habworks/Hab_hc15C/(list of files, drawings)

Other design files:
HAB CAL.PrjPCB
HabLib.PcbLib
HabLib.SchLib
PCB/PCB-HC15C_REV1.PcbDoc
SCH/HARDCAL1_REVA_PG1.SchDoc
SCH/HARDCAL1_REVA_PG2.SchDoc
SCH/HARDCAL1_REVA_PG3.SchDoc
SCH/SCH-HC15C_REV1_PG1.SchDoc
SCH/SCH-HC15C_REV1_PG2.SchDoc
SCH/SCH-HC15C_REV1_PG3.SchDoc
SCH/SCH-HC15C_REV2_PG1.SchDoc
SCH/SCH-HC15C_REV2_PG2.SchDoc
SCH/SCH-HC15C_REV2_PG3.SchDoc
SCH/SCH-HC15C_REV3_PG1.SchDoc
SCH/SCH-HC15C_REV3_PG2.SchDoc
SCH/SCH-HC15C_REV3_PG3.SchDoc
SCH/SCH-HC15C_REV_PG2.SchDoc
