habworks/Hab_hc15C/FIRMWARE/MY CAL_1/METER_TASKS.c

/*****************************************************************
 *
 * File name:       METER_TASKS.C
 * Description:     CTL RTOS Functions used to support Meter (voltage read and continuity)
                    related functions of the HC15C
 * Author:          Hab S. Collector
 * Date:            11/27/11
 * LAST EDIT:       7/16/2012 
 * Hardware:        NXP LPC1769
 * Firmware Tool:   CrossStudio for ARM
 * Notes:           This file should be written as to not be dependent on other includes.
 *                  everything these functions need should be passed to them.  
 *                  It will be necessary to consult the reference documents and associated schematics to understand
 *                  the operations of this firmware.
 *****************************************************************/ 

#include "METER_TASKS.H"
#include "DIP204.H"
#include "ADC_HC15C.H"
#include "LED_HC15C.H"
#include "PWM_HC15C.H"
#include "CORE_FUNCTIONS.H"
#include "TOUCH_TASKS.H"
#include "HC15C_PROTOCOL.H"
#include "USB_LINK.H"
#include "lpc17xx_gpio.h"
#include <ctl_api.h>
#include <stdio.h>
#include <string.h>
#include <math.h>

// GLOBALS
Type_Meter Meter;
Type_OHMS OHMS;
BOOLEAN ContinunityTone = FALSE;


// EXTERNS
extern CTL_EVENT_SET_t CalEvents;
extern CTL_TASK_t meter_task;
extern Type_CalSettings CalSettings;
extern BOOLEAN VCOM_Link;
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
