habworks/Hab_hc15C/(commit log)

2021-06-17 Adding douments and Project and workspace
    [HAB CAL.PrjPCB, HC15C Power Calculations.xlsx, HabLib.PcbLib, HabLib.SchLib]
2021-06-17 Added PCB and OUTPUT
    [PCB-HC15C_REV1.PcbDoc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]
2021-06-17 Added SCH SIM and Project Outputs
    [HARDCAL1_REVA_PG1.SchDoc, HARDCAL1_REVA_PG2.SchDoc, HARDCAL1_REVA_PG3.SchDoc, HC 15C REV1.xls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]
